ElectroIoT/DotGlow-ESP32/docs/README.md

# Docs

| Read this | If you want to |
|---|---|
| [ARCHITECTURE.md](ARCHITECTURE.md) | understand how the firmware is organised (modules, main loop, settings, safe mode, OTA) |
| [PROTOCOL.md](PROTOCOL.md) | talk to the clock over Bluetooth (every command and reply) |
| [DEVELOPMENT.md](DEVELOPMENT.md) | build, flash and test the firmware yourself |
| [RELEASE.md](RELEASE.md) | publish a new firmware version |
| [`pcb/`](pcb) | pictures of the DotGlow V1 board (2D layout, 3D renders, banner, logos) |

The `*.svg` files in this folder are the animated pictures used in the main README (digit animations, effects, wiring).
They are generated by `tools/make_images.py`, so do not edit them by hand.
