ElectroIoT/DotGlow-ESP32/hardware/pcb/video/index.html

OPEN HARDWARE

DotGlow
V1 Board

From schematic to PCB to 3D

1 SCHEMATIC

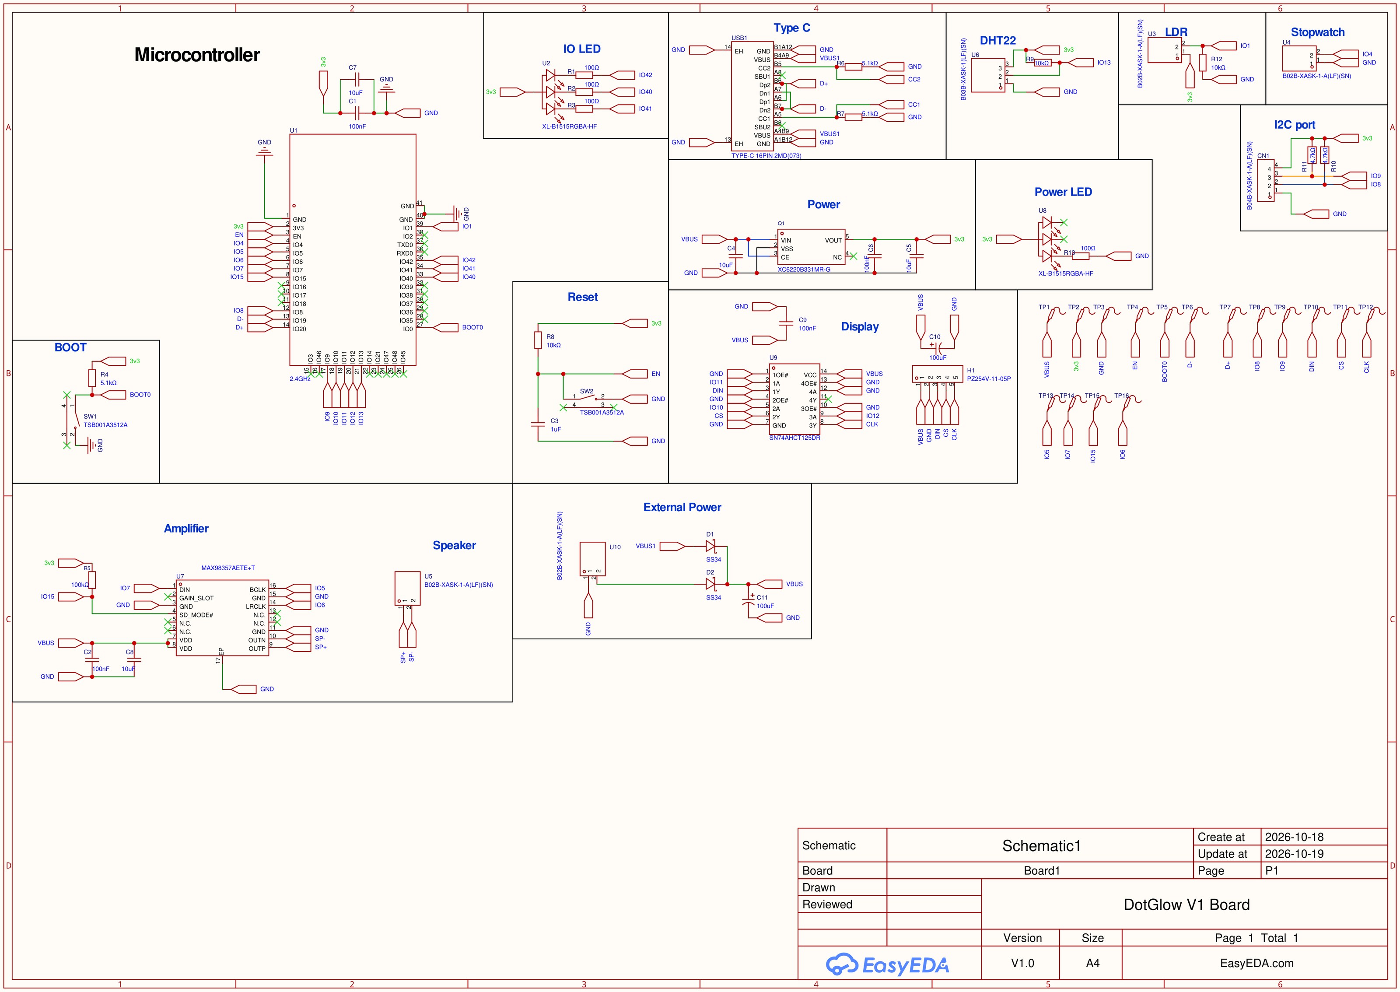
[picture p17: hardware/pcb/video/assets/img/schematic.jpg]
DotGlow V1 schematic


ESP32-S3, USB-C, amplifier, level shifter

0 ERC errors22 BOM lines16 test points

2 PCB LAYOUT

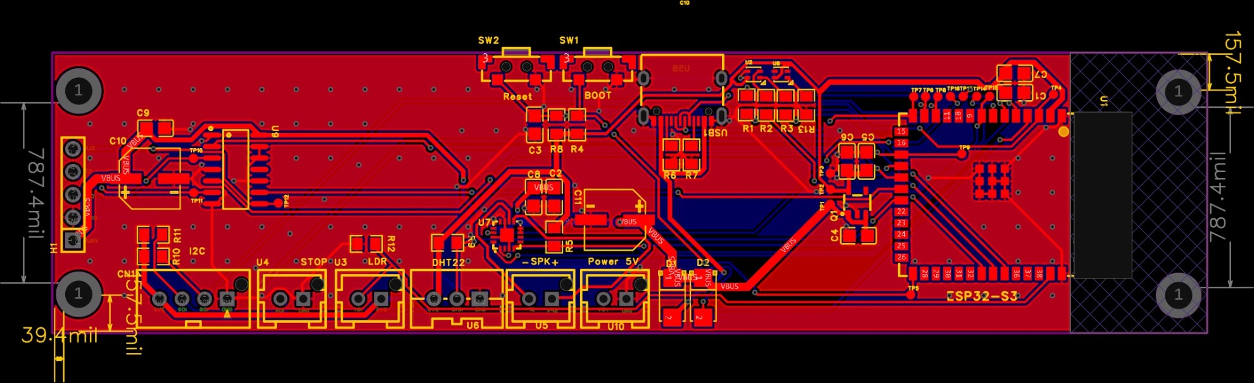
[picture p18: hardware/pcb/video/assets/img/layout2d.jpg]
PCB layout


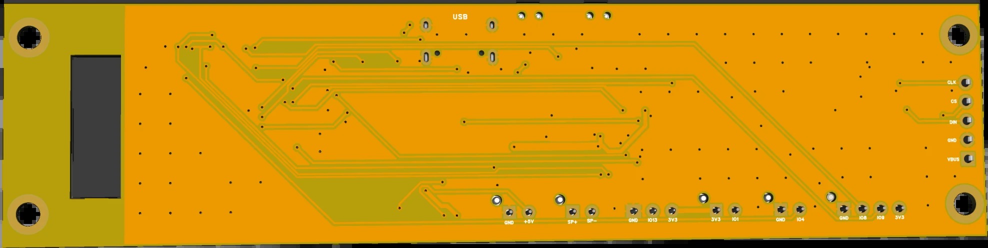
[picture p19: hardware/pcb/video/assets/img/bottom-orange.jpg]
PCB bottom


128 x 31.1 mm, 2 layers

GND pourAntenna keep-outDRC: 0 errorsGerbers ready

3 3D MODEL

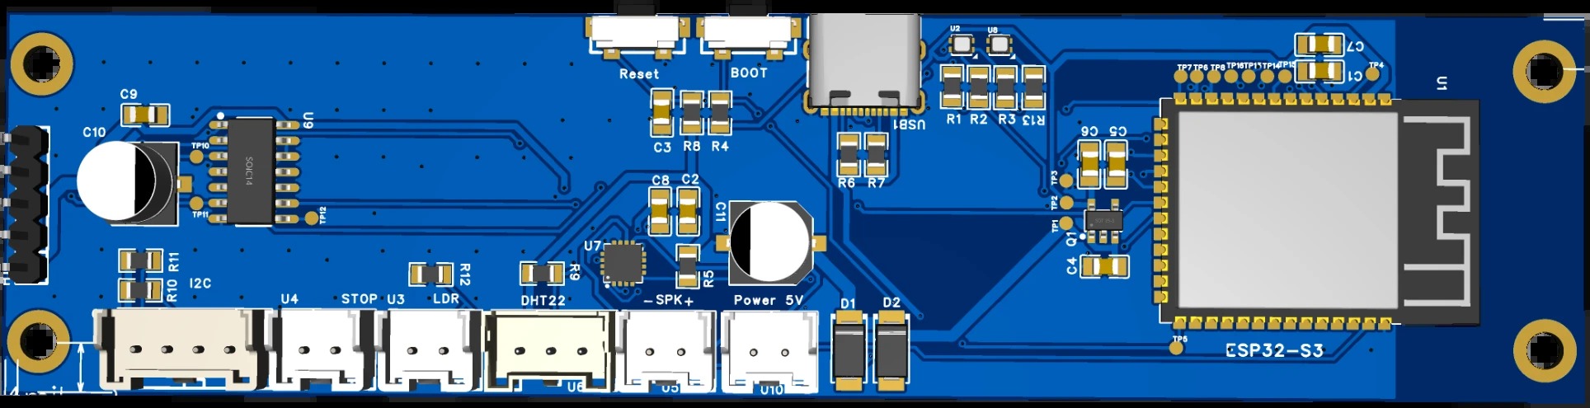
[picture p20: hardware/pcb/video/assets/img/top-blue.jpg]
top


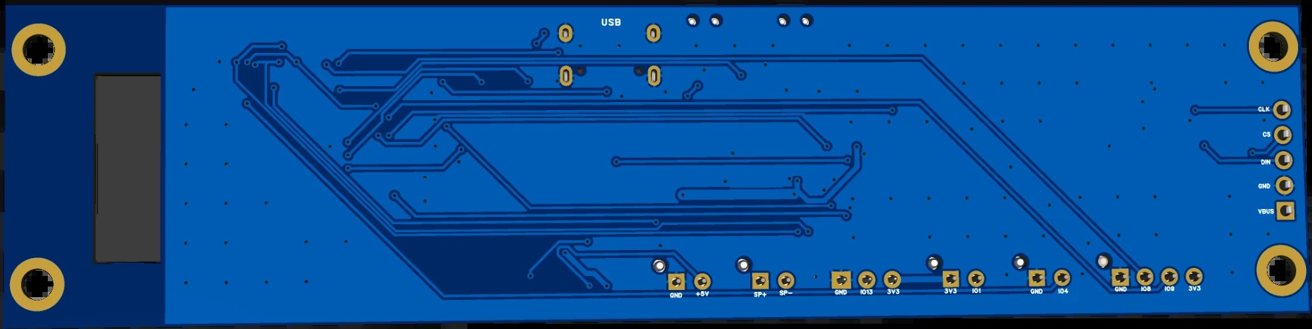
[picture p21: hardware/pcb/video/assets/img/bottom-blue.jpg]
bottom


Top and bottom, every side

3D VIEWER

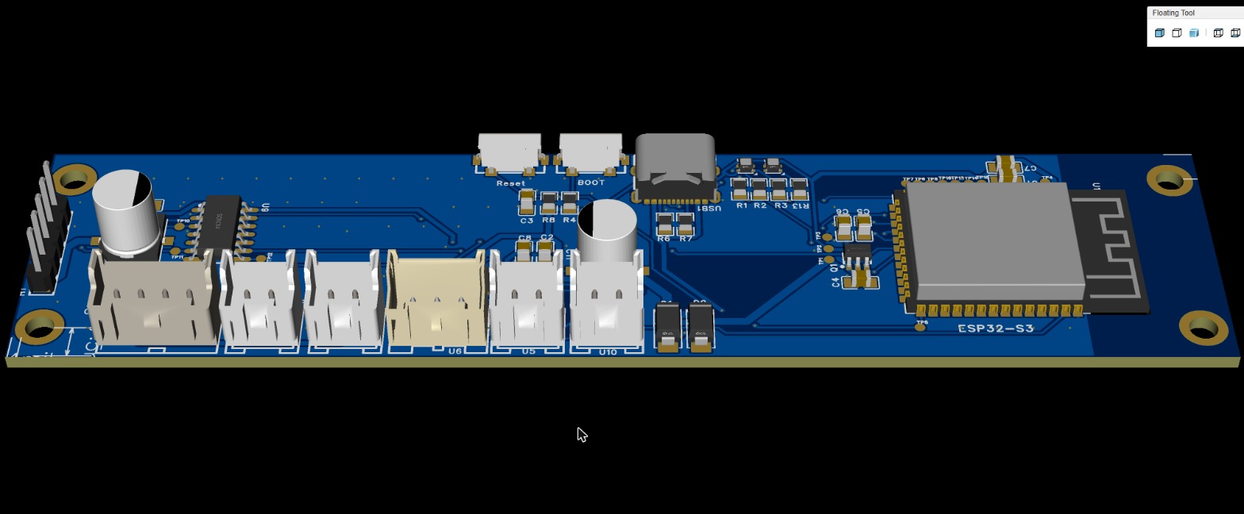
[picture p22: hardware/pcb/video/assets/img/view-front.jpg]
front
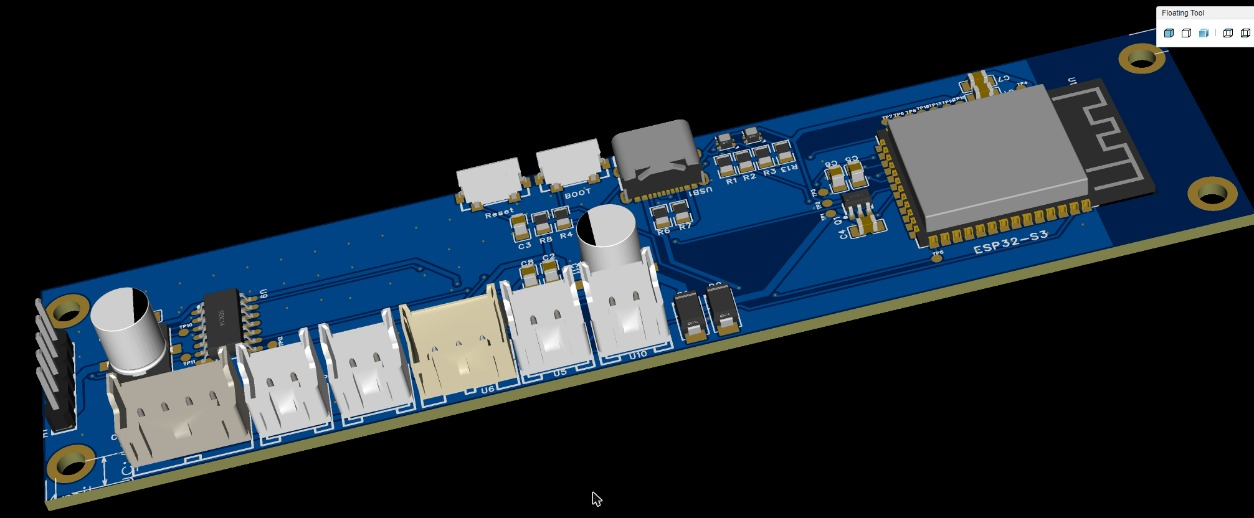
[picture p23: hardware/pcb/video/assets/img/view-angle-1.jpg]
angle 1
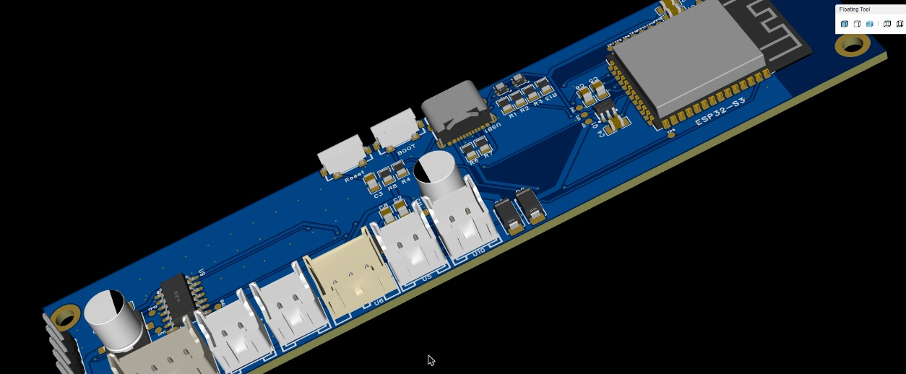
[picture p24: hardware/pcb/video/assets/img/view-angle-2.jpg]
angle 2
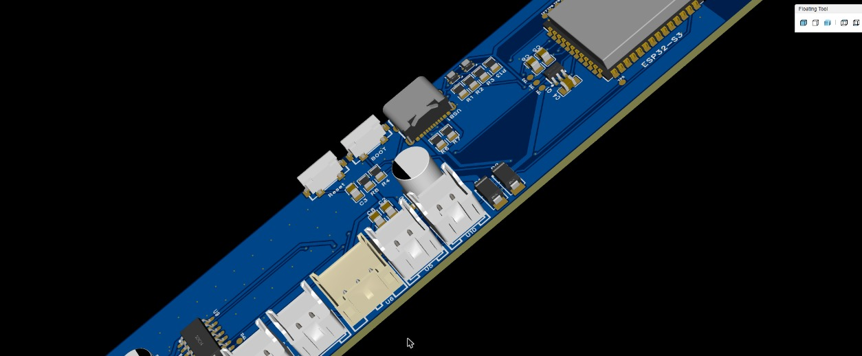
[picture p25: hardware/pcb/video/assets/img/view-angle-3.jpg]
angle 3
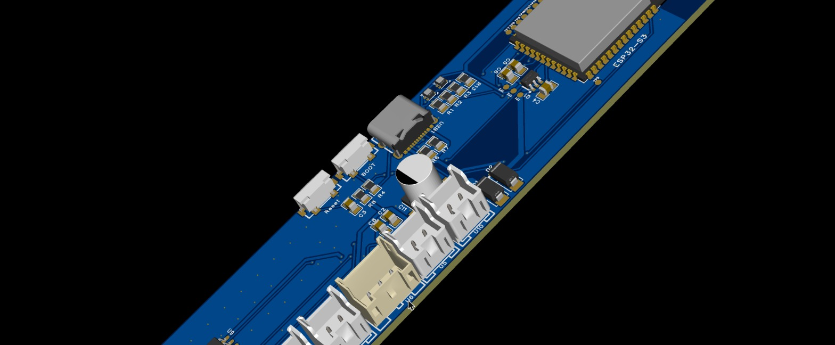
[picture p26: hardware/pcb/video/assets/img/view-closeup.jpg]
closeup
    

Every angle, real parts

USB-C, JST XA connectors, ESP32-S3 module

YOUR COLOUR

blue

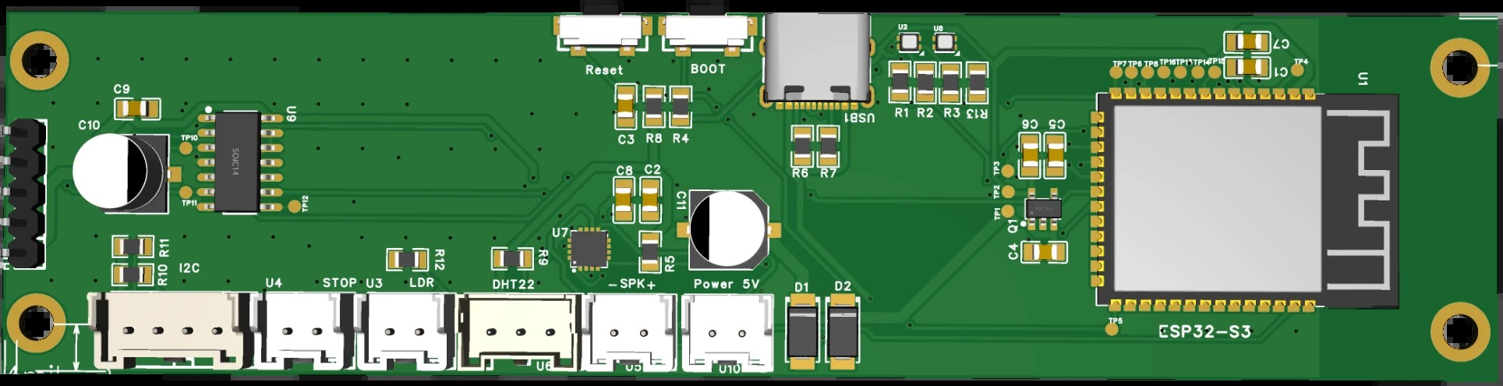
[picture p27: hardware/pcb/video/assets/img/top-green.jpg]
green


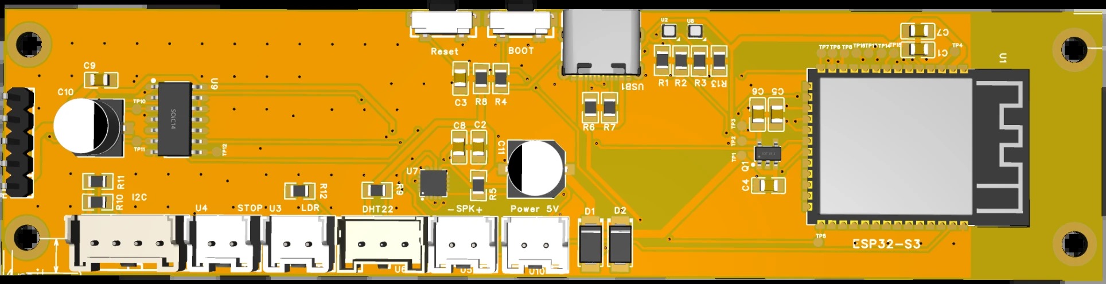
[picture p28: hardware/pcb/video/assets/img/top-orange.jpg]
orange


Blue, green or orange mask

OPEN SOURCE

DotGlow
V1 Board

KiCadEasyEDAGerber + BOM

github.com/ElectroIoT/DotGlow-ESP32

ELECTROIOT.IN
