ElectroIoT/DotGlow-ESP32/docs/pcb/final/pcb-2d-layout.png

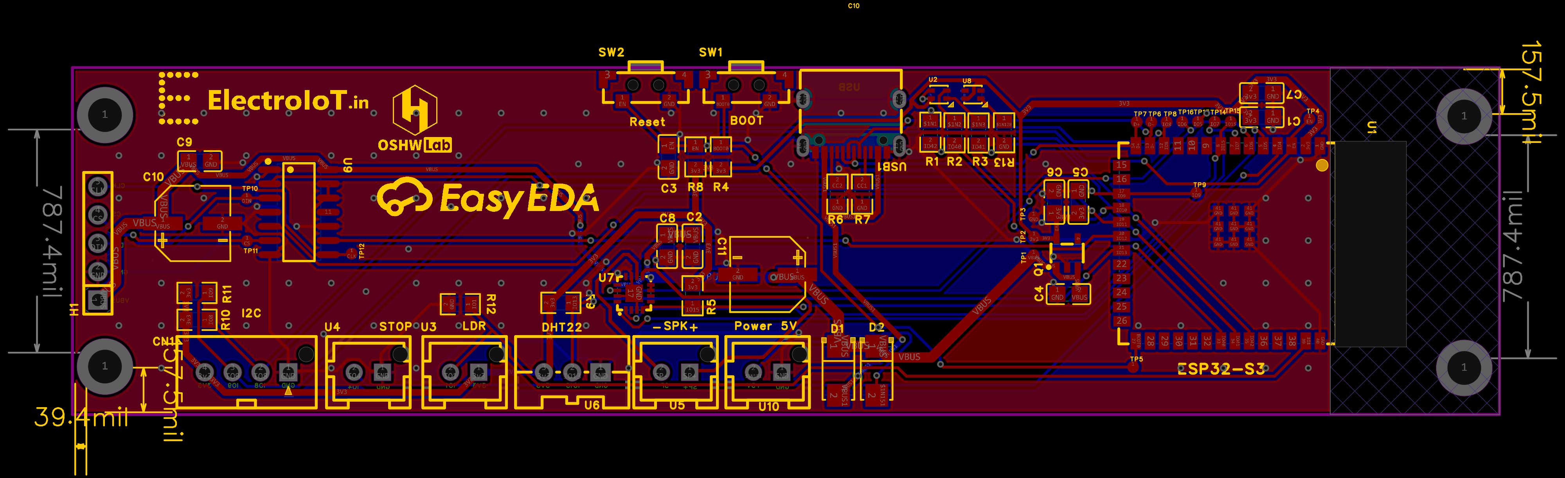
docs/pcb/final/pcb-2d-layout.png
