ElectroIoT/DotGlow-ESP32/docs/pcb/final/pcb-3d-angle-blue.png

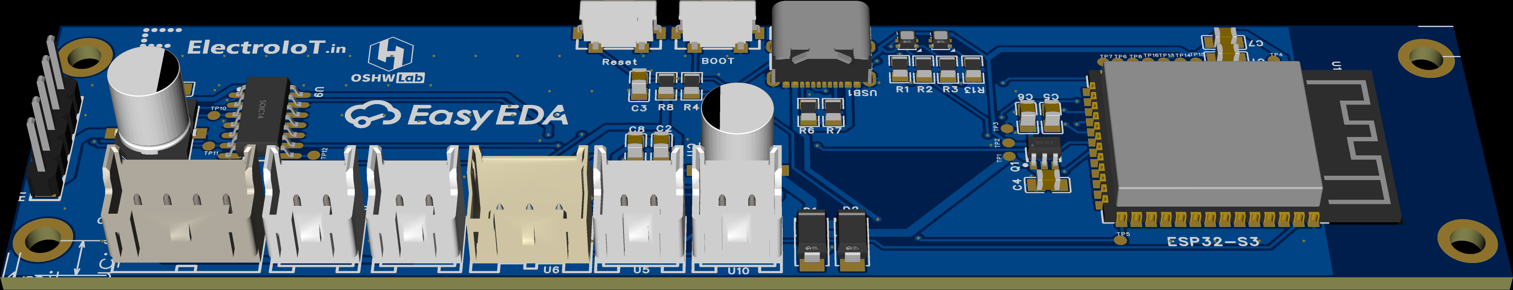
docs/pcb/final/pcb-3d-angle-blue.png
