ElectroIoT/DotGlow-ESP32/docs/pcb/final/pcb-3d-bottom-blue.png

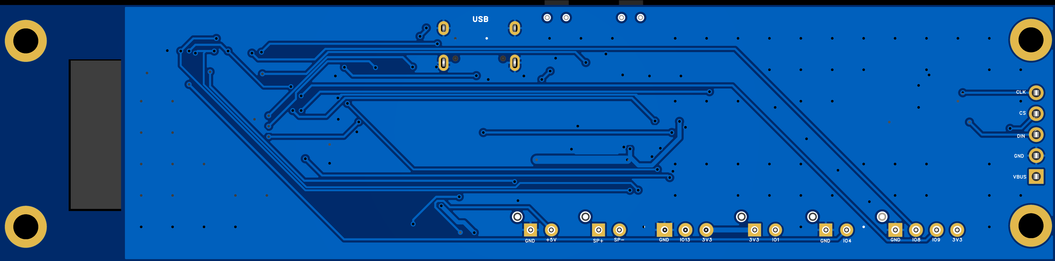
docs/pcb/final/pcb-3d-bottom-blue.png
