ElectroIoT/DotGlow-ESP32/docs/pcb/final/pcb-3d-top-blue.png

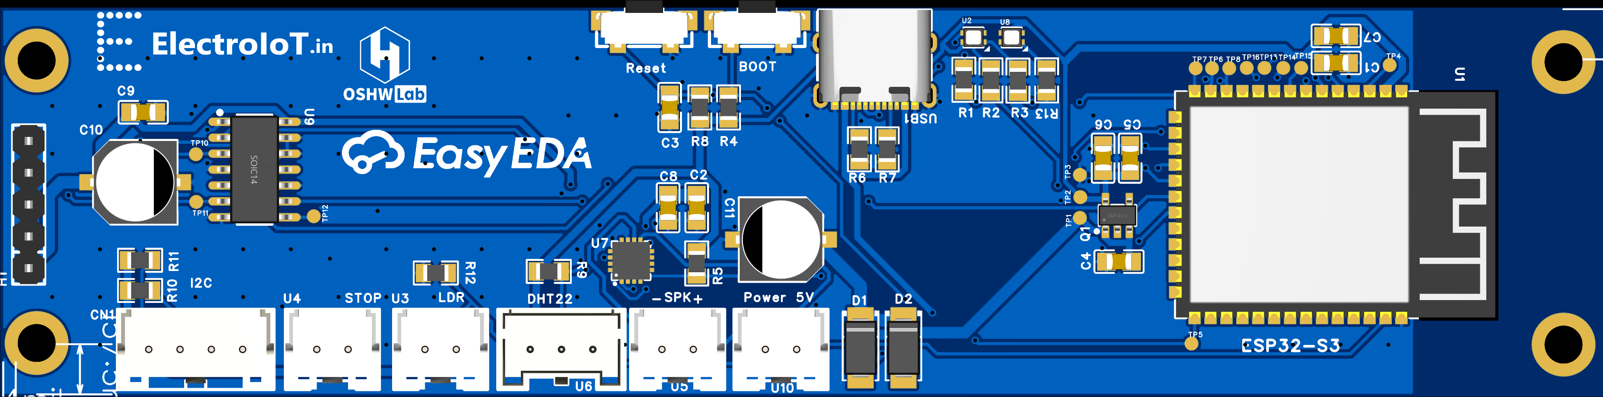
docs/pcb/final/pcb-3d-top-blue.png
