ElectroIoT/DotGlow-ESP32/docs/pcb/oshwlab/clock-animation.gif

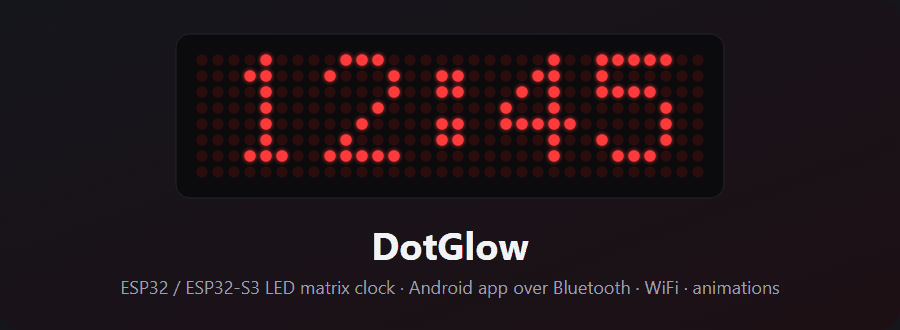
docs/pcb/oshwlab/clock-animation.gif
