ElectroIoT/DotGlow-ESP32/docs/pcb/oshwlab/cover-3d-transparent.png

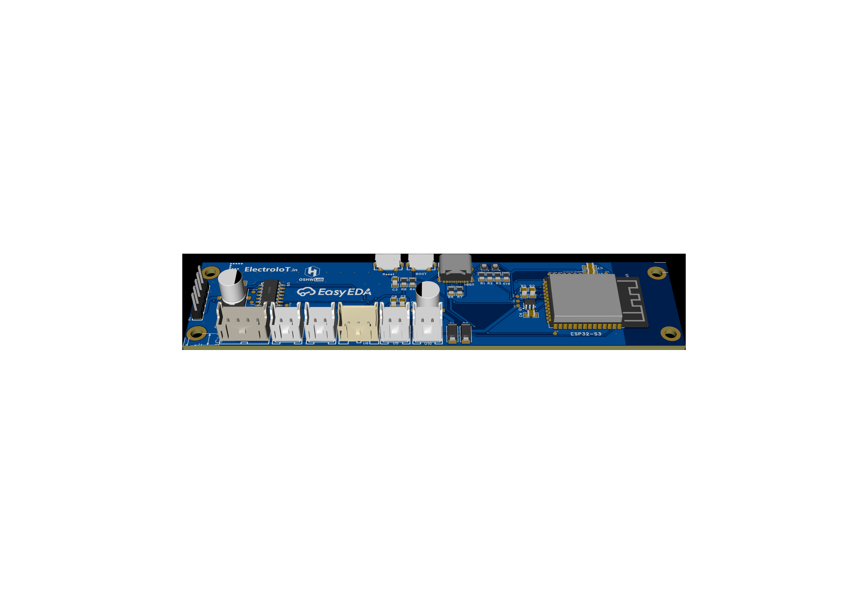
docs/pcb/oshwlab/cover-3d-transparent.png
