ElectroIoT/DotGlow-ESP32/docs/pcb/oshwlab/cover-pcb-3d-padded.jpg

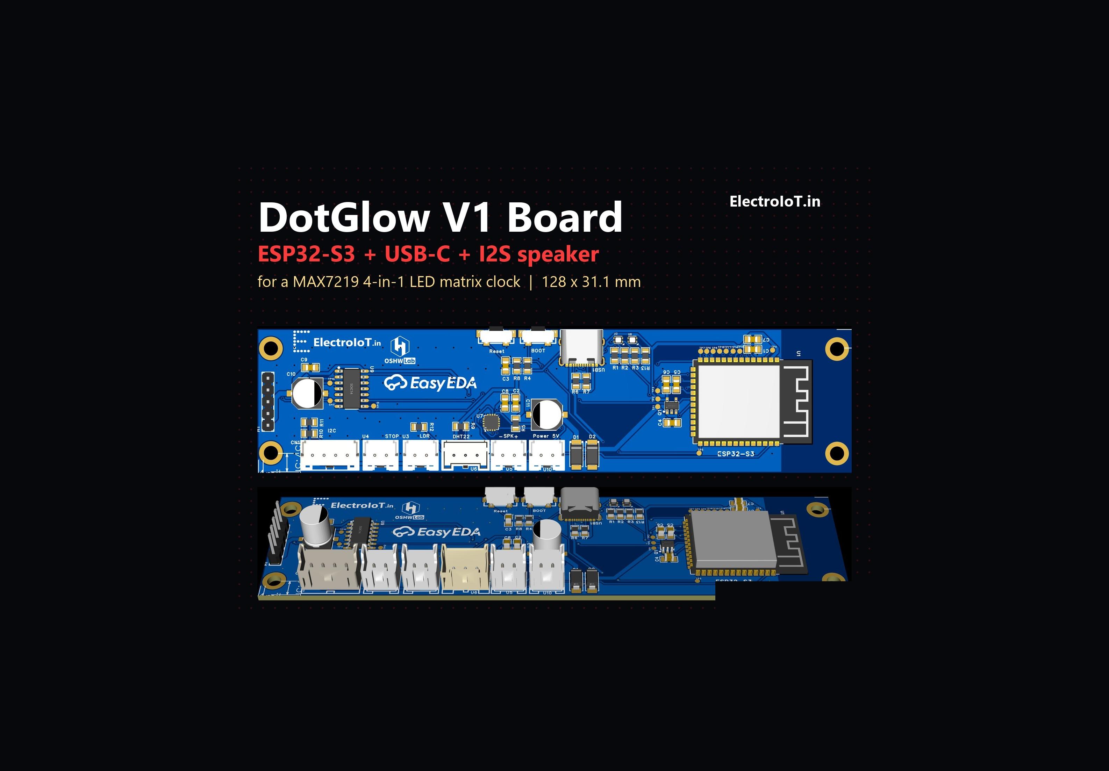
docs/pcb/oshwlab/cover-pcb-3d-padded.jpg
