ElectroIoT/DotGlow-ESP32/docs/pcb/oshwlab/cover-product-padded.jpg

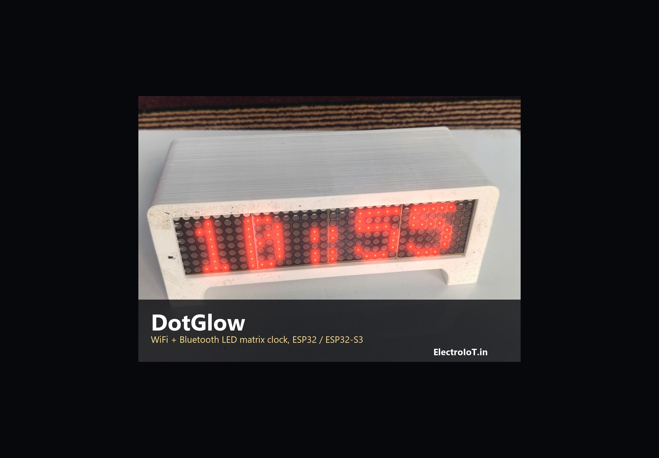
docs/pcb/oshwlab/cover-product-padded.jpg
