ElectroIoT/DotGlow-ESP32/docs/pcb/oshwlab/cover-product.jpg

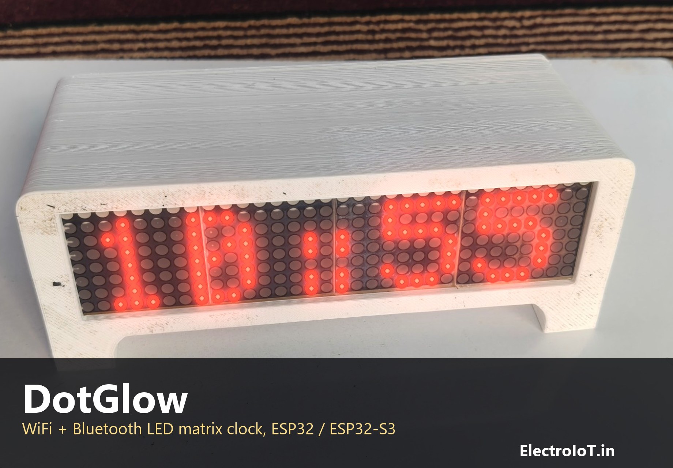
docs/pcb/oshwlab/cover-product.jpg
