ElectroIoT/DotGlow-ESP32/docs/pcb/pcb-3d-bottom-green.png

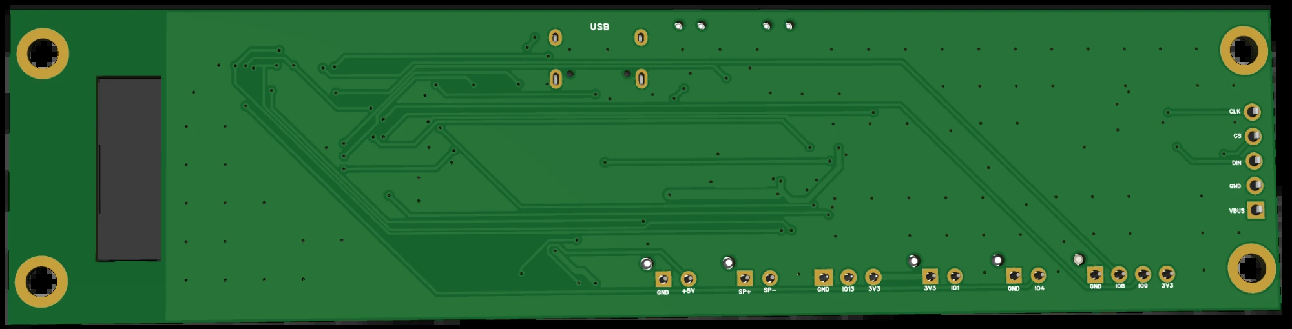
docs/pcb/pcb-3d-bottom-green.png
