ElectroIoT/DotGlow-ESP32/docs/pcb/pcb-3d-side-left.png

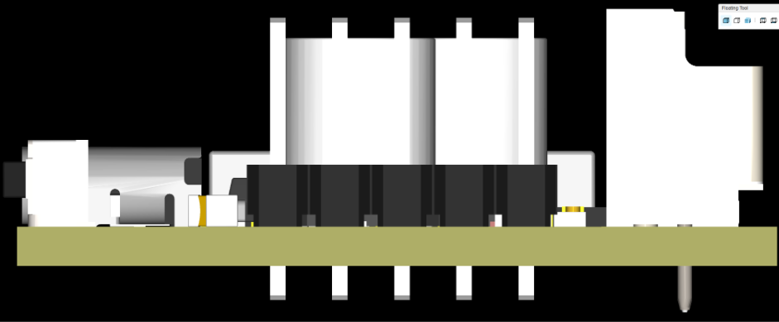
docs/pcb/pcb-3d-side-left.png
