ElectroIoT/DotGlow-ESP32/docs/pcb/pcb-3d-side-right.png

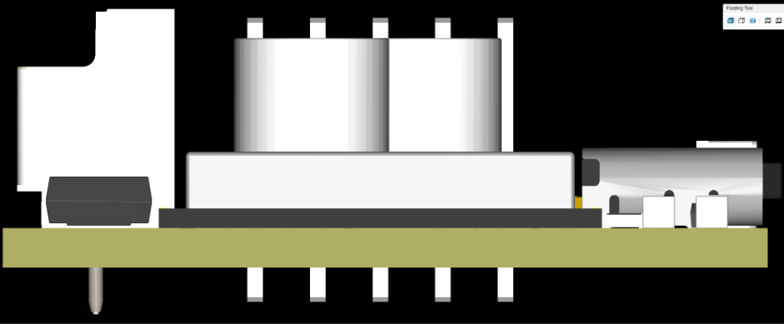
docs/pcb/pcb-3d-side-right.png
