ElectroIoT/DotGlow-ESP32/docs/pcb/pcb-3d-top-orange.png

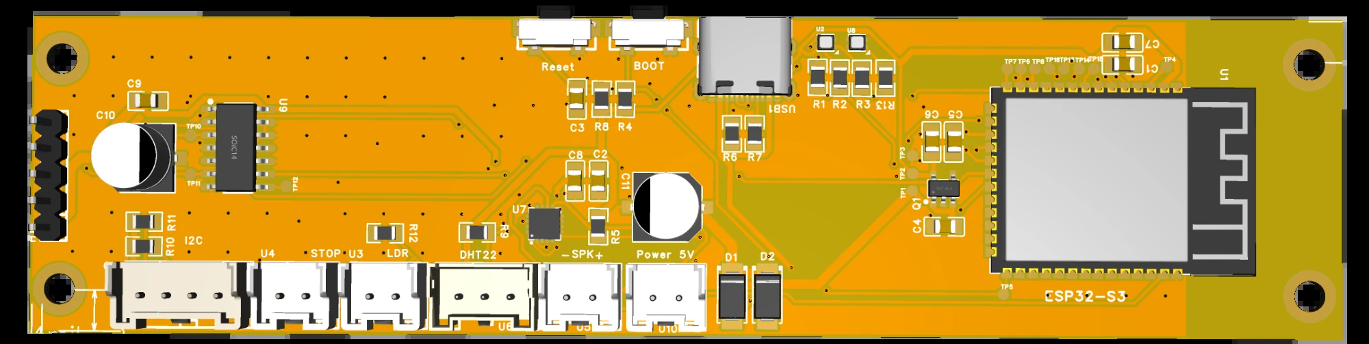
docs/pcb/pcb-3d-top-orange.png
