ElectroIoT/DotGlow-ESP32/docs/pcb/pcbway-cover-7x5.jpg

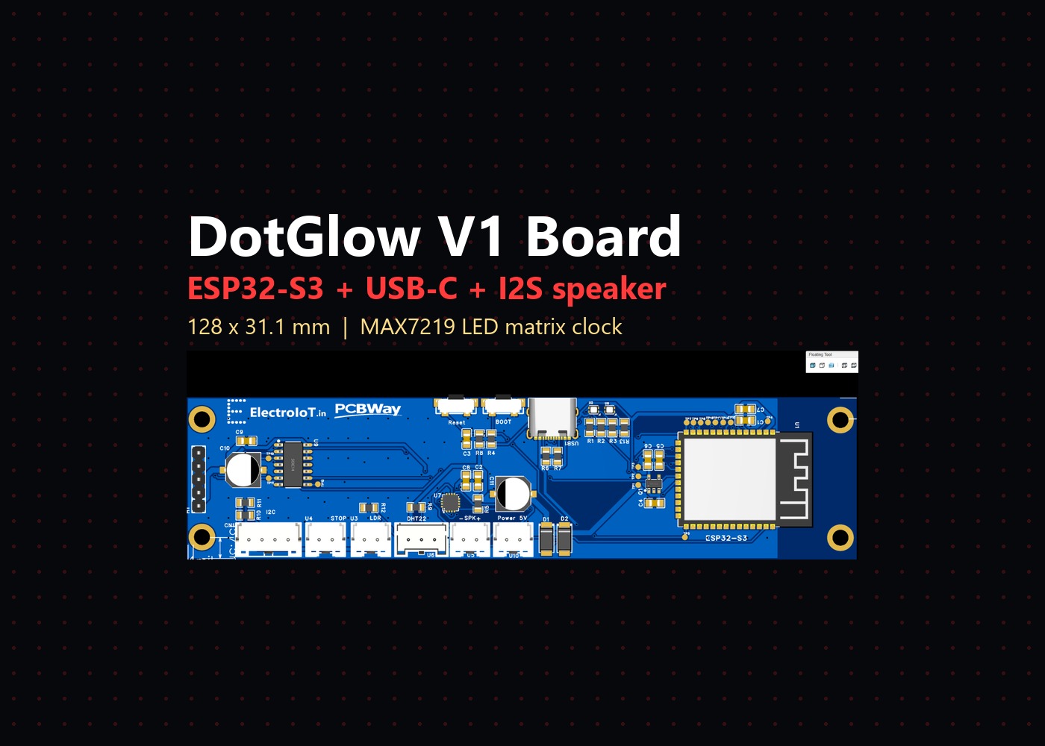
docs/pcb/pcbway-cover-7x5.jpg
