ElectroIoT/DotGlow-ESP32/docs/pcb/pcbway-project-cover.jpg

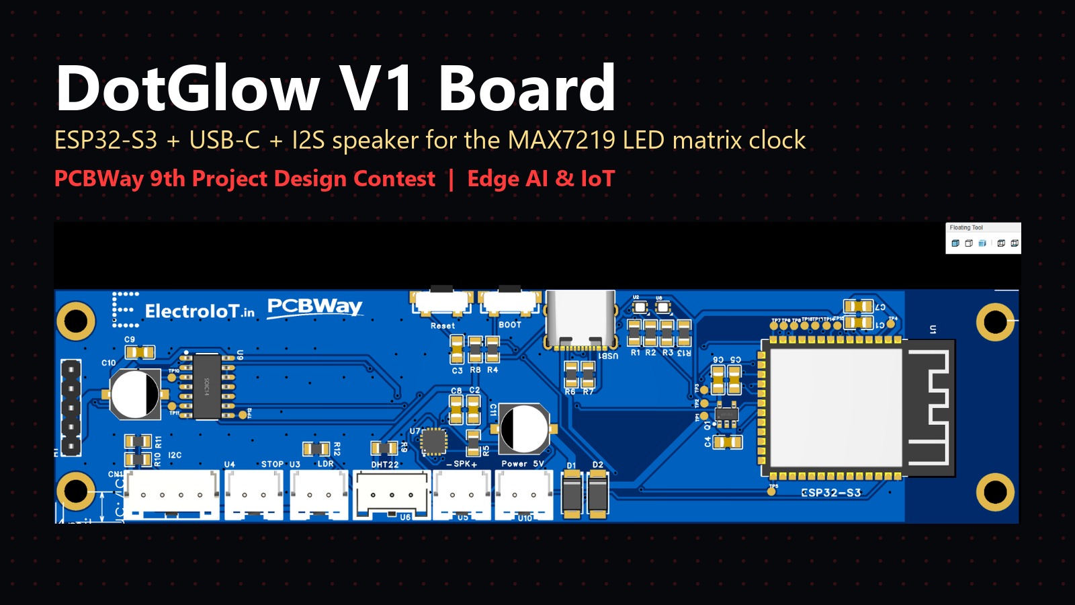
docs/pcb/pcbway-project-cover.jpg
