ElectroIoT/DotGlow-ESP32/docs/pcb/thumb-pcb-short.jpg

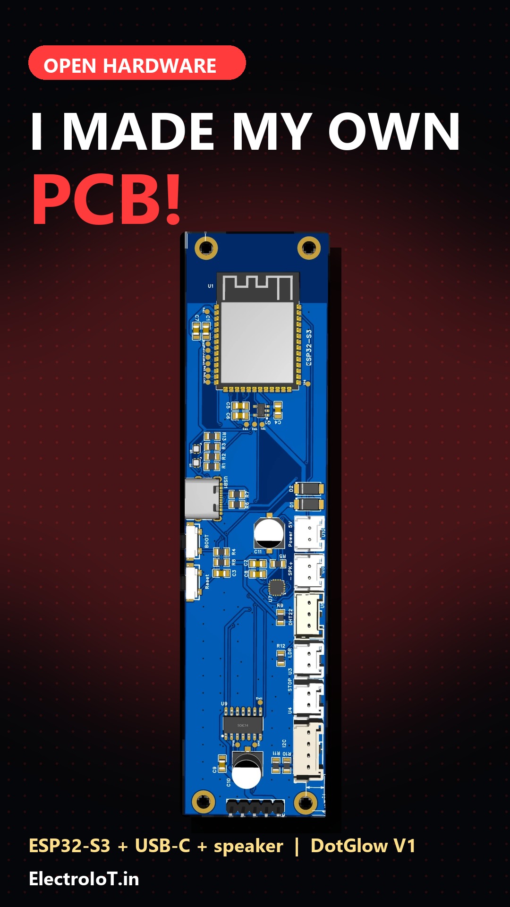
docs/pcb/thumb-pcb-short.jpg
