ElectroIoT/DotGlow-ESP32/docs/pcb/thumb-pcb-wide.jpg

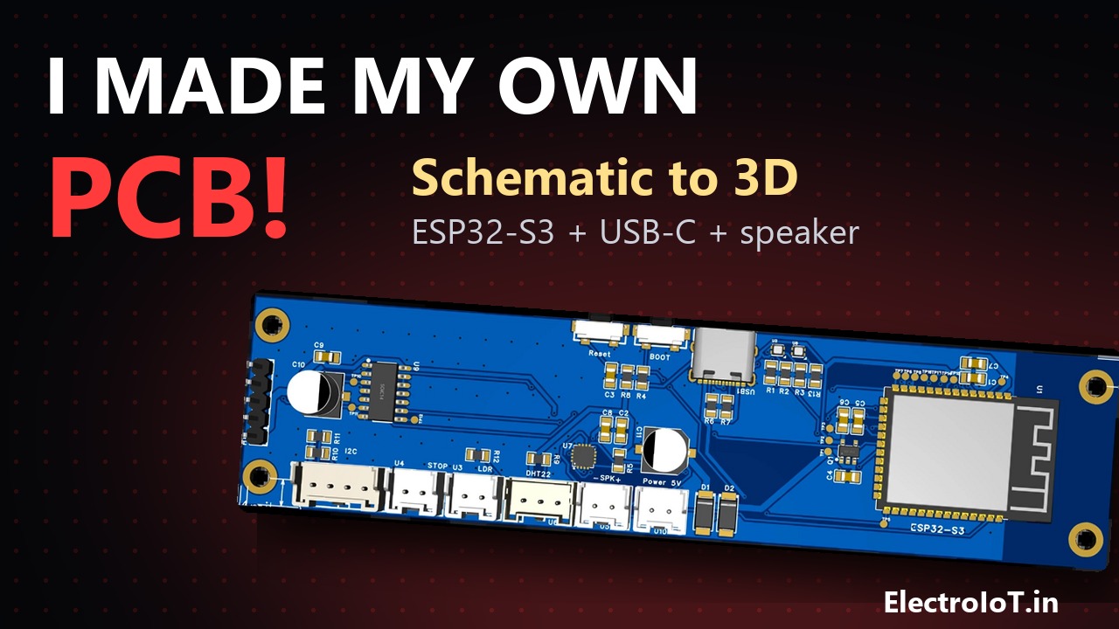
docs/pcb/thumb-pcb-wide.jpg
