ElectroIoT/DotGlow-ESP32/hardware/enclosure/images/case-front-straight.png

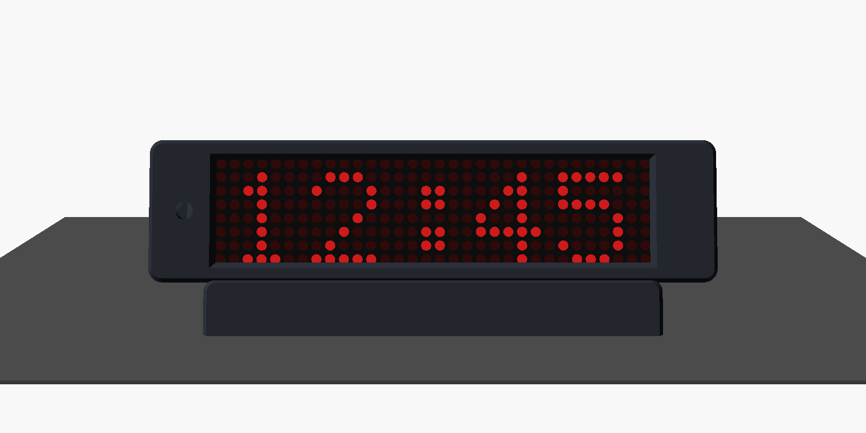
hardware/enclosure/images/case-front-straight.png
