ElectroIoT/DotGlow-ESP32/hardware/pcb/layout/dotglow-v1-layout.png

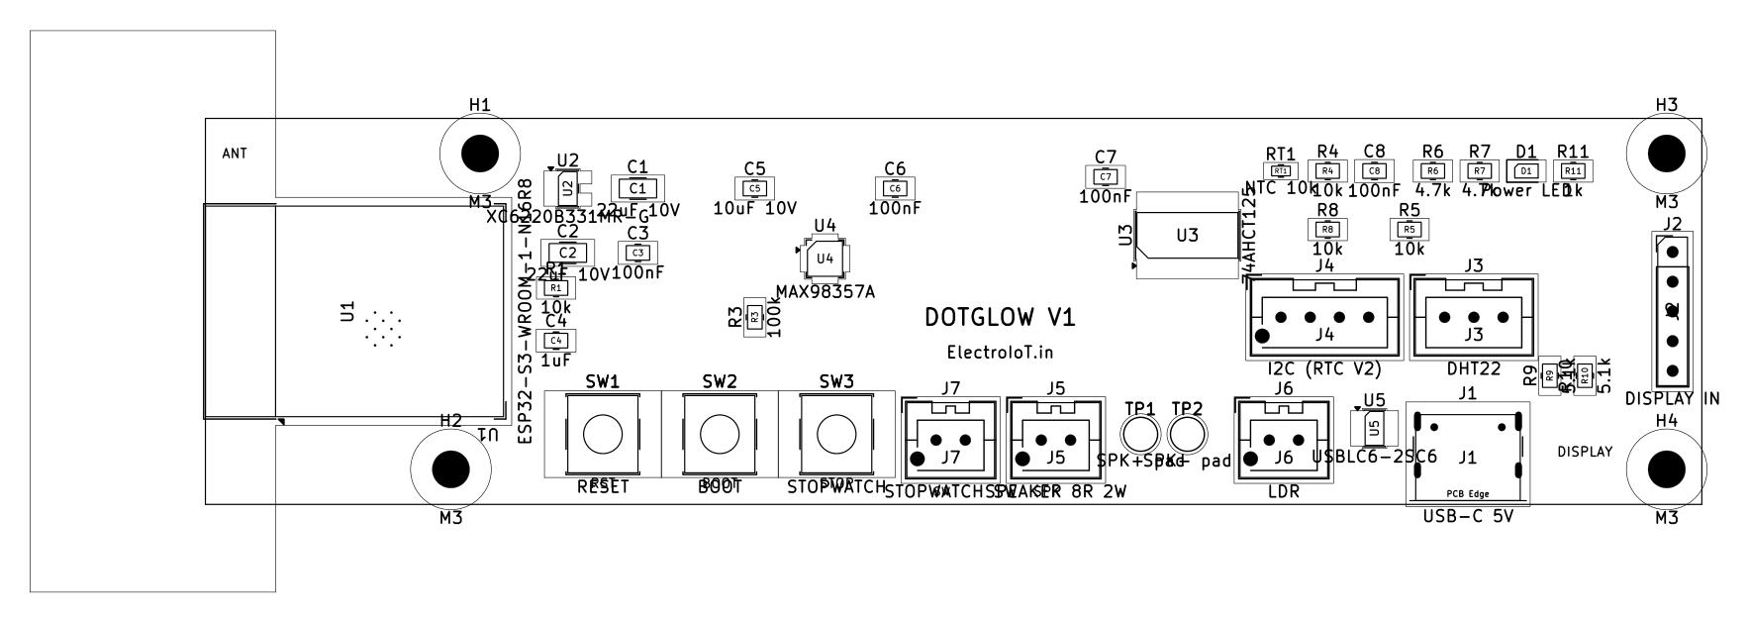
hardware/pcb/layout/dotglow-v1-layout.png
