ElectroIoT/DotGlow-ESP32/hardware/pcb/renders/pcb_bottom.png

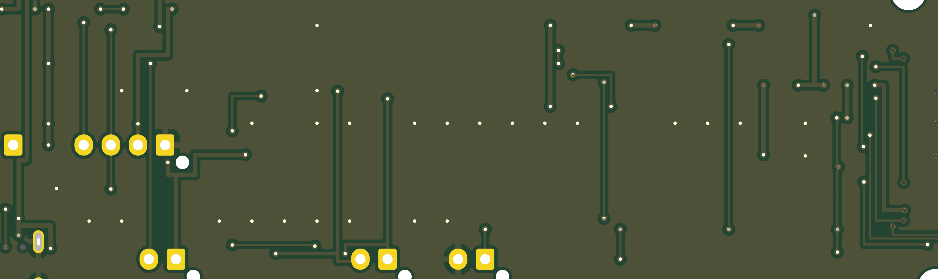
hardware/pcb/renders/pcb_bottom.png
