ElectroIoT/DotGlow-ESP32/hardware/pcb/renders/pcb_top.png

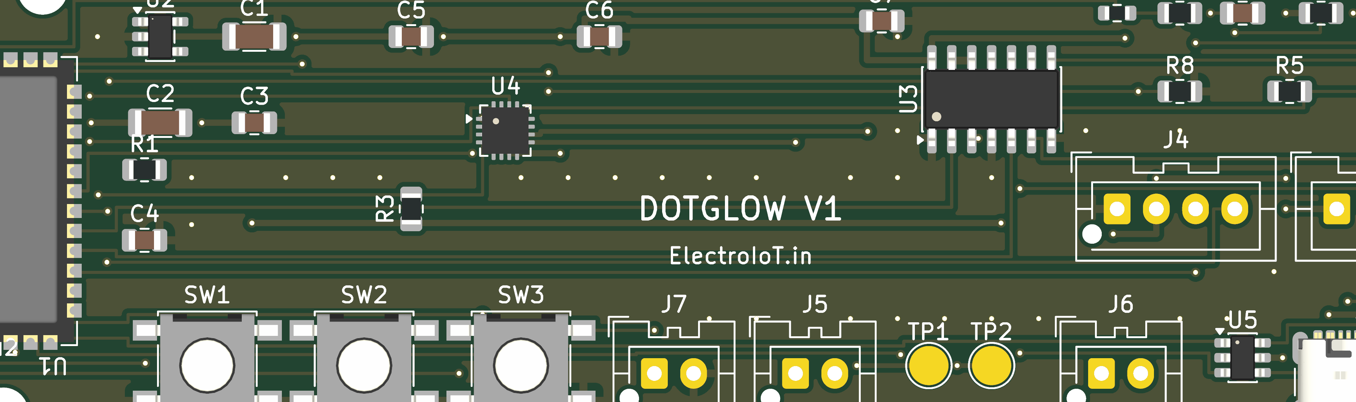
hardware/pcb/renders/pcb_top.png
