ElectroIoT/DotGlow-ESP32/hardware/pcb/bom/dotglow-v1-bom.csv

No. | Quantity | Comment | Designator | Footprint | Value | Manufacturer Part | Manufacturer | Supplier Part | Supplier
1 | 4 | 100nF | C1,C2,C6,C9 | C0805 | 100nF | CC0805KRX7R9BB104 | YAGEO(国巨) | C49678 | LCSC
2 | 1 | 1uF | C3 | C0805 | 1uF | TCC0805X7R105K500DTS | CCTC(三环) | C344178 | LCSC
3 | 4 | 10uF | C4,C5,C7,C8 | C0805 | 10uF | GRM21BR61H106KE43L | muRata(村田) | C440198 | LCSC
4 | 2 | 100uF | C10,C11 | CAP-SMD_BD6.3-L6.6-W6.6-LS7.2-FD | 100uF | RVT1V101M0607 100UF 35V | DMBJ(振宝佳) | C970686 | LCSC
5 | 1 | B04B-XASK-1-A(LF)(SN) | CN1 | CONN-TH_B04B-XASK-1-A-LF-SN |  | B04B-XASK-1-A(LF)(SN) | JST | C491709 | LCSC
6 | 2 | SS34 | D1,D2 | SMA_L4.3-W2.6-LS5.2-RD |  | SS34 | MDD(辰达半导体) | C8678 | LCSC
7 | 1 | PZ254V-11-05P | H1 | HDR-TH_5P-P2.54-V-M |  | PZ254V-11-05P | XFCN(兴飞) | C492404 | LCSC
8 | 1 | XC6220B331MR-G | Q1 | SOT-25_L3.0-W1.6-P0.95-LS2.8-TL |  | XC6220B331MR-G | TOREX(特瑞仕) | C86534 | LCSC
9 | 4 | 100Ω | R1,R2,R3,R13 | R0805 | 100Ω | RC0805FR-07100RL | YAGEO(国巨) | C105577 | LCSC
10 | 3 | 5.1kΩ | R4,R6,R7 | R0805 | 5.1kΩ | 0805W8F5101T5E | UNI-ROYAL(厚声) | C27834 | LCSC
11 | 1 | 100kΩ | R5 | R0805 | 100kΩ | 0805W8F1003T5E | UNI-ROYAL(厚声) | C149504 | LCSC
12 | 3 | 10kΩ | R8,R9,R12 | R0805 | 10kΩ | 0805W8F1002T5E | UNI-ROYAL(厚声) | C17414 | LCSC
13 | 2 | 4.7kΩ | R10,R11 | R0805 | 4.7kΩ | FRC0805F4701TS | FOJAN(富捷) | C2907264 | LCSC
14 | 2 | TSB001A3512A | SW1,SW2 | SW-SMD_TSB001XXXX |  | TSB001A3512A | BZCN(博众电气) | C2888948 | LCSC
15 | 16 | Test-Point | TP1,TP2,TP3,TP4,TP5,TP6,TP7,TP8,TP9,TP10,TP11,TP12,TP13,TP14,TP15,TP16 | Test-Point-0.5mm
16 | 1 | 2.4GHz | U1 | WIRELM-SMD_ESP32-S3-WROOM-1 | 2.4GHz | ESP32-S3-WROOM-1-N16R8 | ESPRESSIF(乐鑫) | C2913202 | LCSC
17 | 2 | XL-B1515RGBA-HF | U2,U8 | LED-SMD_4P-L1.6-W1.5_WHITE-LED |  | XL-B1515RGBA-HF | XINGLIGHT(成兴光) | C22461781 | LCSC
18 | 4 | B02B-XASK-1-A(LF)(SN) | U3,U4,U5,U10 | CONN-TH_B02B-XASK-1-A-LF-SN |  | B02B-XASK-1-A(LF)(SN) | JST | C265077 | LCSC
19 | 1 | B03B-XASK-1(LF)(SN) | U6 | CONN-TH_B03B-XASK-1-LF-SN |  | B03B-XASK-1(LF)(SN) | JST | C265055 | LCSC
20 | 1 | MAX98357AETE+T | U7 | TQFN-16_L3.0-W3.0-P0.50-BL-EP1.5 |  | MAX98357AETE+T | ADI(亚德诺)/MAXIM(美信) | C910544 | LCSC
21 | 1 | SN74AHCT125DR | U9 | SOIC-14_L8.7-W3.9-P1.27-LS6.0-BL |  | SN74AHCT125DR | TI(德州仪器) | C155176 | LCSC
22 | 1 | TYPE-C 16PIN 2MD(073) | USB1 | USB-C-SMD_TYPE-C-16PIN-2MD-073 |  | TYPE-C 16PIN 2MD(073) | SHOU HAN(首韩) | C2765186 | LCSC
