ElectroIoT/DotGlow-ESP32/hardware/pcb/fab/dotglow-v1-bom.csv

Comment | Designator | Footprint | Qty | Suggested part / note
22uF 10V | C1,C2 | C_1206_3216Metric | 2
100nF | C3,C6,C7,C8 | C_0805_2012Metric | 4
1uF | C4 | C_0805_2012Metric | 1
10uF 10V | C5 | C_0805_2012Metric | 1
Power LED | D1 | LED_0805_2012Metric | 1
USB-C 5V | J1 | USB_C_Receptacle_GCT_USB4105-xx-A_16P_TopMnt_Horizontal | 1 | GCT USB4105-GF-A
DISPLAY IN | J2 | PinHeader_1x05_P2.54mm_Vertical | 1 | XFCN PZ254V-11-05P 1x5 pin header (LCSC C492404)
DHT22 | J3 | JST_XA_B03B-XASK-1_1x03_P2.50mm_Vertical | 1 | JST B03B-XASK-1 (LCSC C265055)
I2C (RTC V2) | J4 | JST_XA_B04B-XASK-1-A_1x04_P2.50mm_Vertical | 1 | JST B04B-XASK-1-A (LCSC C491709)
SPEAKER 8R 2W | J5 | JST_XA_B02B-XASK-1-A_1x02_P2.50mm_Vertical | 1 | JST B02B-XASK-1-A (LCSC C265077)
LDR | J6 | JST_XA_B02B-XASK-1-A_1x02_P2.50mm_Vertical | 1 | JST B02B-XASK-1-A (LCSC C265077)
STOPWATCH SW | J7 | JST_XA_B02B-XASK-1-A_1x02_P2.50mm_Vertical | 1 | JST B02B-XASK-1-A (LCSC C265077)
10k | R1,R4,R5,R8 | R_0805_2012Metric | 4
1k | R11 | R_0805_2012Metric | 1
100k | R3 | R_0805_2012Metric | 1
4.7k | R6,R7 | R_0805_2012Metric | 2
5.1k | R10,R9 | R_0805_2012Metric | 2
NTC 10k | RT1 | R_0603_1608Metric | 1 | 10k NTC, B=3950, 0603 (e.g. NCP18XH103F03RB)
RESET | SW1 | SW_SPST_B3S-1000 | 1 | 6x6 SMD tact switch
BOOT | SW2 | SW_SPST_B3S-1000 | 1 | 6x6 SMD tact switch
STOPWATCH | SW3 | SW_SPST_B3S-1000 | 1 | 6x6 SMD tact switch
SPK+ pad | TP1 | TestPoint_Pad_D2.5mm | 1
SPK- pad | TP2 | TestPoint_Pad_D2.5mm | 1
ESP32-S3-WROOM-1-N16R8 | U1 | ESP32-S3-WROOM-1 | 1 | ESP32-S3-WROOM-1-N16R8 (LCSC C2913202)
XC6220B331MR-G | U2 | SOT-23-5 | 1 | XC6220B331MR-G (LCSC C86534), 1 A, pin-compatible with AP2112K-3.3 (C51118)
74AHCT125 | U3 | SOIC-14_3.9x8.7mm_P1.27mm | 1 | SN74AHCT125DR (LCSC C155176)
MAX98357A | U4 | TQFN-16-1EP_3x3mm_P0.5mm_EP1.6x1.6mm | 1 | MAX98357AETE+T (LCSC C910544)
USBLC6-2SC6 | U5 | SOT-23-6 | 1 | USBLC6-2SC6
