ElectroIoT/DotGlow-ESP32/hardware/pcb/layout/dotglow-v1-full-layout.dxf

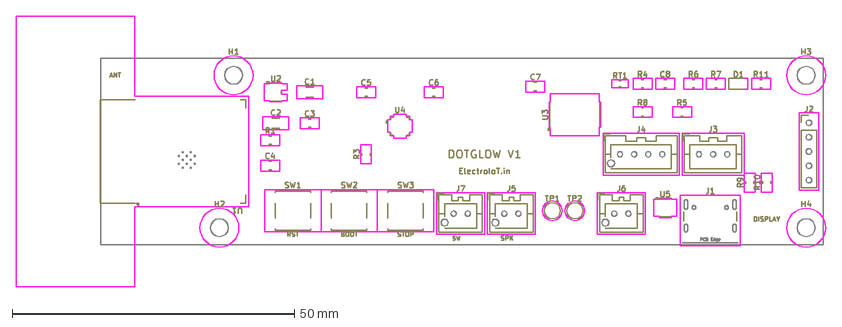
[picture p51: CAD file, 2026-10-20]
hardware/pcb/layout/dotglow-v1-full-layout.dxf
143.4 x 48.0 mm
