ElectroIoT/DotGlow-ESP32/hardware/enclosure/stl/6-modules-plus/dotglow-testfit.stl

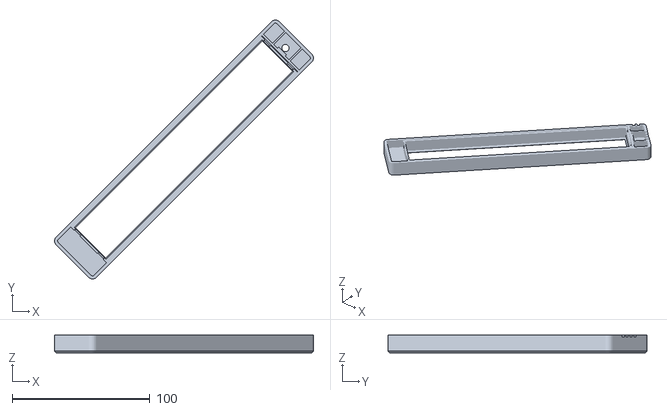
[picture p52: CAD file, 2026-10-05]
hardware/enclosure/stl/6-modules-plus/dotglow-testfit.stl
187.7 x 187.7 x 12.8
