ElectroIoT/DotGlow-ESP32/hardware/enclosure/stl/6-modules-plus/esp32-devkit-30pin/shell-no-button.stl

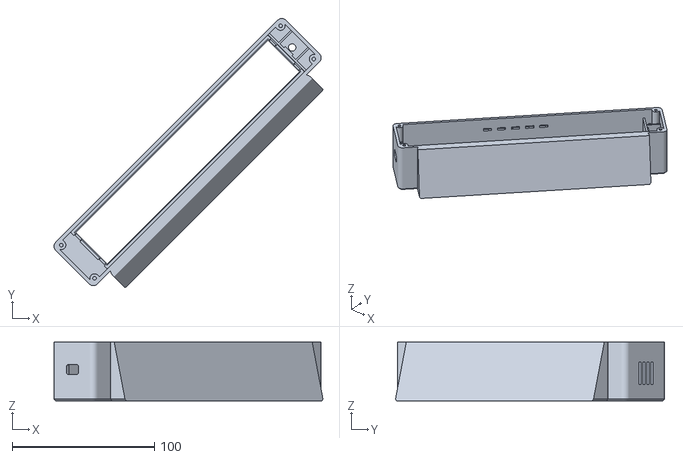
[picture p53: CAD file, 2026-10-05]
hardware/enclosure/stl/6-modules-plus/esp32-devkit-30pin/shell-no-button.stl
189.1 x 189.1 x 41.2
