ElectroIoT/DotGlow-ESP32/hardware/enclosure/stl/6-modules-plus/esp32-devkit-38pin/back.stl

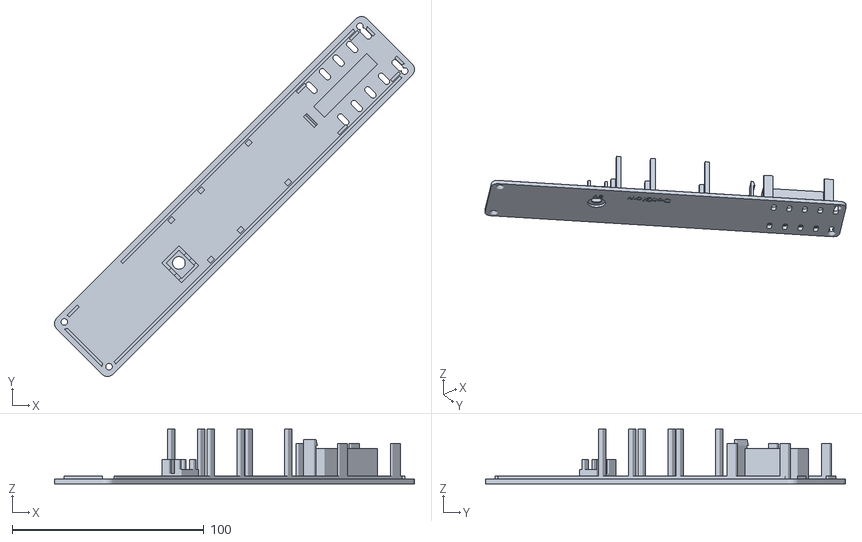
[picture p54: CAD file, 2026-10-05]
hardware/enclosure/stl/6-modules-plus/esp32-devkit-38pin/back.stl
187.7 x 187.7 x 28.5
