ElectroIoT/DotGlow-ESP32/hardware/enclosure/stl/6-modules-plus/esp8266-nodemcu-v3/shell-snap-button.stl

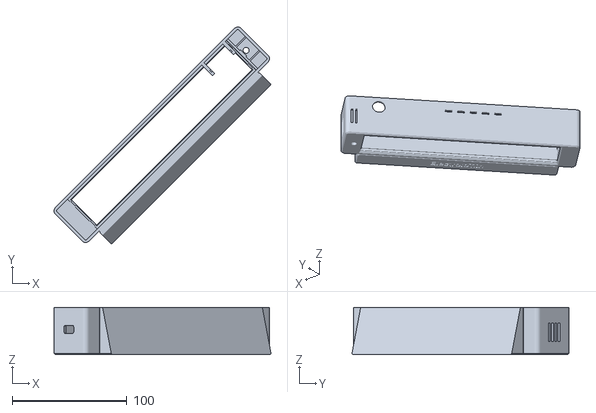
[picture p56: CAD file, 2026-10-05]
hardware/enclosure/stl/6-modules-plus/esp8266-nodemcu-v3/shell-snap-button.stl
189.1 x 189.1 x 41.2
