ElectroIoT/DotGlow-ESP32/hardware/enclosure/stl/6-modules/dotglow-testfit.stl

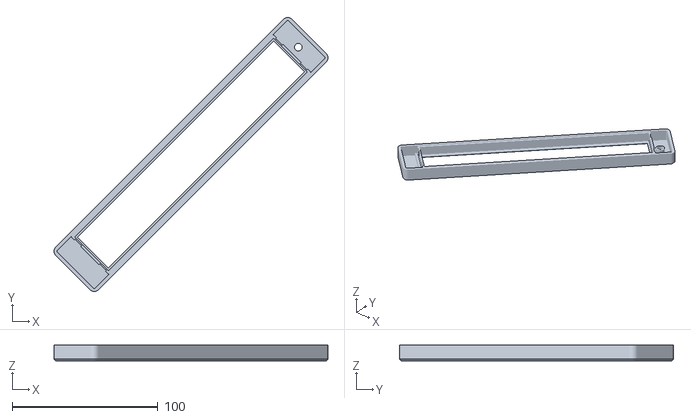
[picture p57: CAD file, 2026-10-05]
hardware/enclosure/stl/6-modules/dotglow-testfit.stl
187.7 x 187.7 x 10.8
