ElectroIoT/DotGlow-ESP32/hardware/enclosure/stl/dotglow-testfit.stl

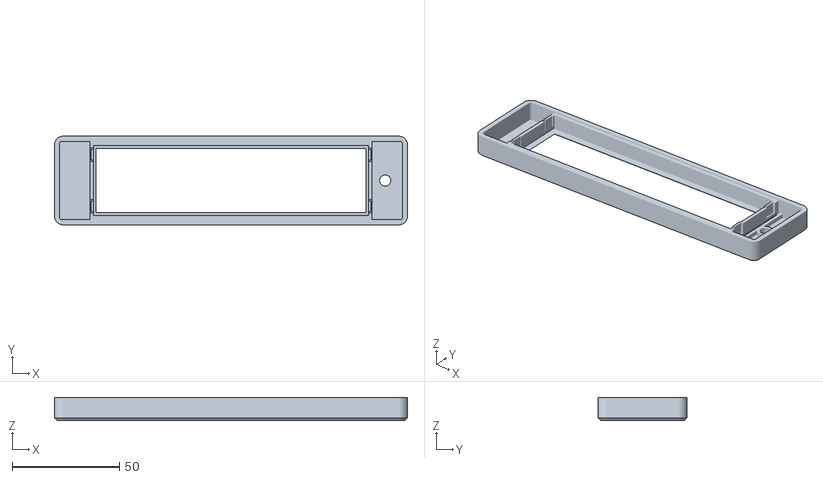
[picture p58: CAD file, 2026-10-05]
hardware/enclosure/stl/dotglow-testfit.stl
164.8 x 41.4 x 10.8
