ElectroIoT/DotGlow-ESP32/hardware/enclosure/stl/extras/esp32-s3-back-panel-jack.stl

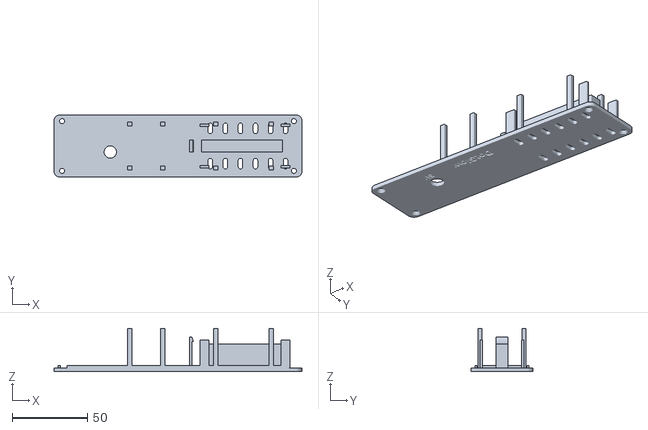
[picture p59: CAD file, 2026-10-05]
hardware/enclosure/stl/extras/esp32-s3-back-panel-jack.stl
164.8 x 41.4 x 28.8
