ElectroIoT/DotGlow-ESP32/hardware/enclosure/stl/variants/dotglow-shell-snap.stl

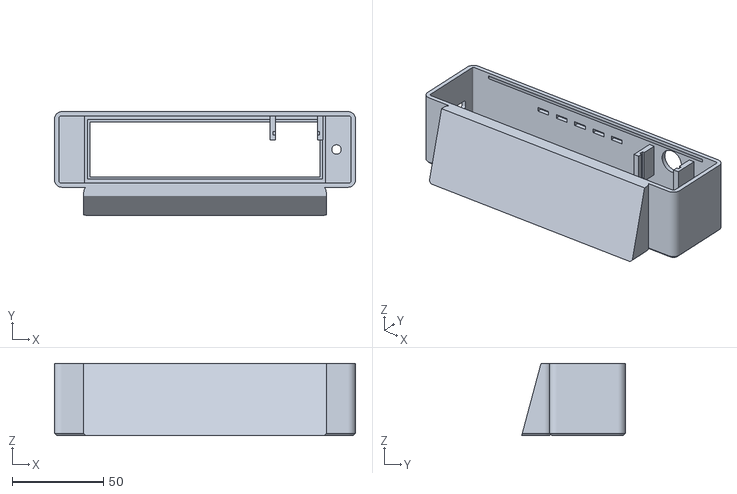
[picture p60: CAD file, 2026-10-05]
hardware/enclosure/stl/variants/dotglow-shell-snap.stl
164.8 x 56.8 x 39.5
