ElectroIoT/DotGlow-ESP32/hardware/enclosure/stl/6-modules-plus/dotglow-nameplate-inlay.stl

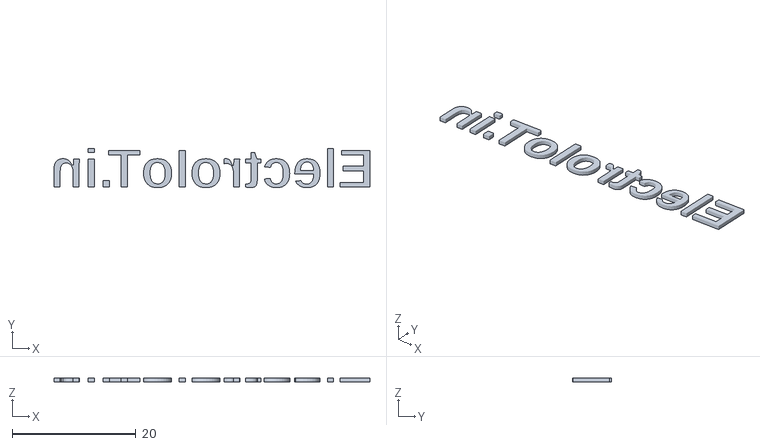
[picture p61: CAD file, 2026-10-05]
hardware/enclosure/stl/6-modules-plus/dotglow-nameplate-inlay.stl
51.1 x 6.39 x 0.6
