ElectroIoT/DotGlow-ESP32/hardware/enclosure/stl/extras/esp32-s3-shell-lean30-button.stl

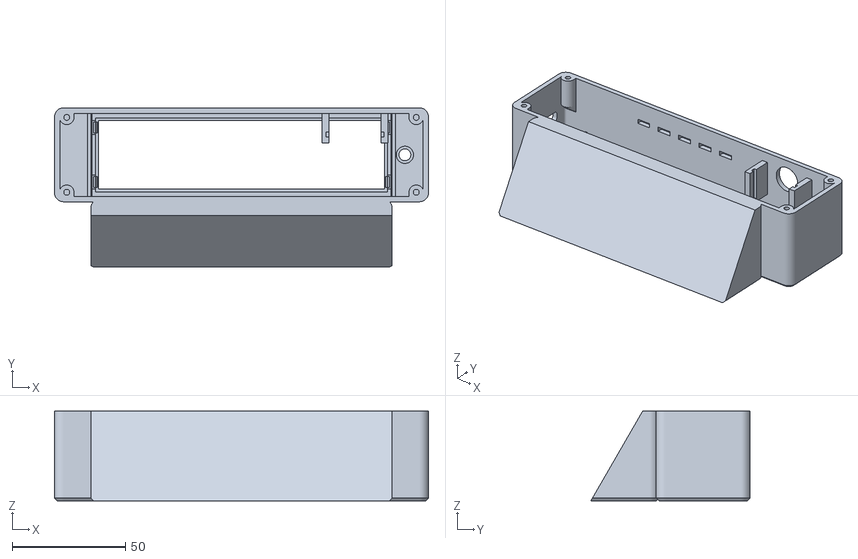
[picture p62: CAD file, 2026-10-05]
hardware/enclosure/stl/extras/esp32-s3-shell-lean30-button.stl
164.8 x 70.2 x 39.5
