ElectroIoT/DotGlow-ESP32/hardware/pcb/layout/dotglow-v1-outline-128x31p1.dxf

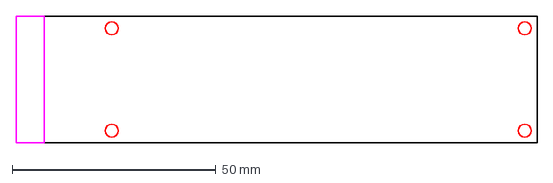
[picture p63: CAD file, 2026-10-20]
hardware/pcb/layout/dotglow-v1-outline-128x31p1.dxf
128.0 x 31.1 mm
