ElectroIoT/DotGlow-ESP32/hardware/enclosure/stl/6-modules-plus/dotglow-light-shield.stl

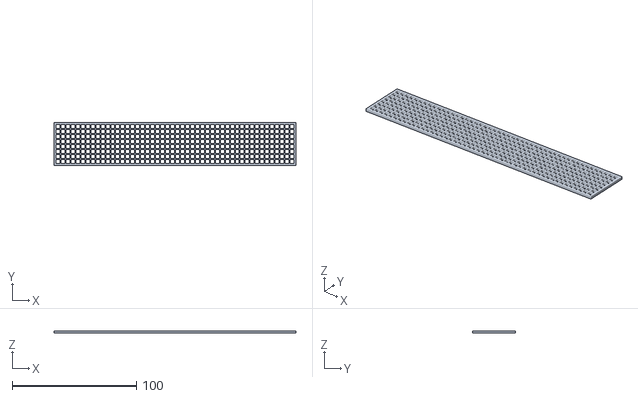
[picture p64: CAD file, 2026-10-05]
hardware/enclosure/stl/6-modules-plus/dotglow-light-shield.stl
194.4 x 34.4 x 2.00
