ElectroIoT/DotGlow-ESP32/hardware/enclosure/stl/6-modules-plus/esp32-s3/back-snap.stl

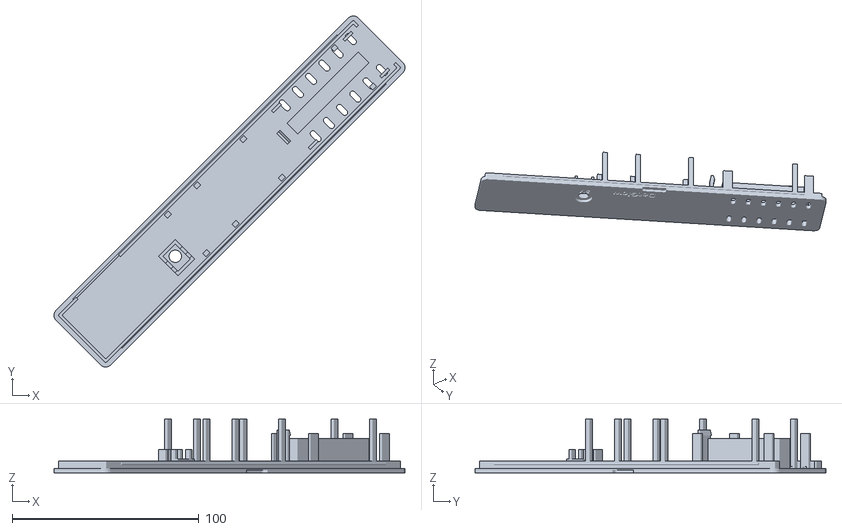
[picture p65: CAD file, 2026-10-05]
hardware/enclosure/stl/6-modules-plus/esp32-s3/back-snap.stl
187.7 x 187.7 x 28.8
