ElectroIoT/DotGlow-ESP32/hardware/pcb/layout/dotglow-v1-outline-holes.dxf

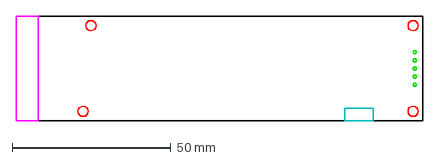
[picture p67: CAD file, 2026-10-20]
hardware/pcb/layout/dotglow-v1-outline-holes.dxf
128.0 x 33.0 mm
