ElectroIoT/DotGlow-ESP32/hardware/enclosure/stl/6-modules-plus/esp32-s3/back.stl

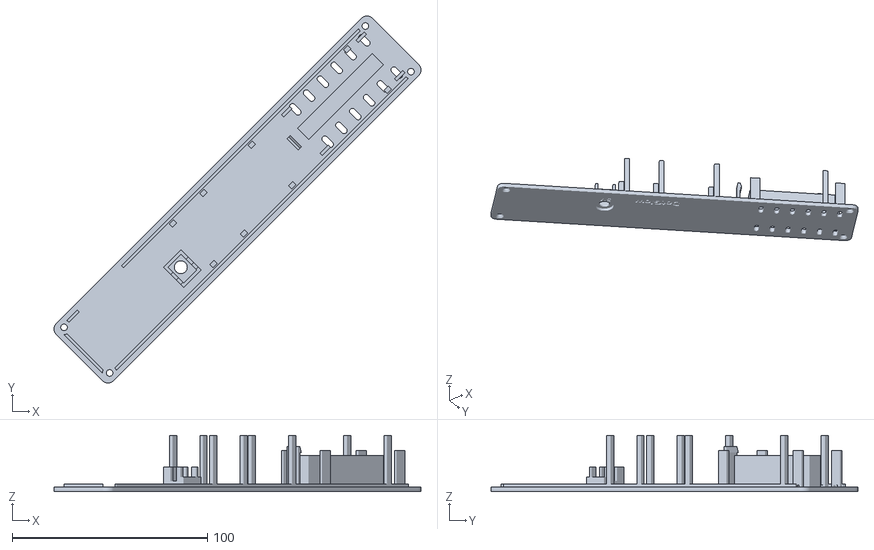
[picture p68: CAD file, 2026-10-05]
hardware/enclosure/stl/6-modules-plus/esp32-s3/back.stl
187.7 x 187.7 x 28.8
