ElectroIoT/DotGlow-ESP32/hardware/enclosure/stl/6-modules-plus/esp32-s3/shell-button.stl

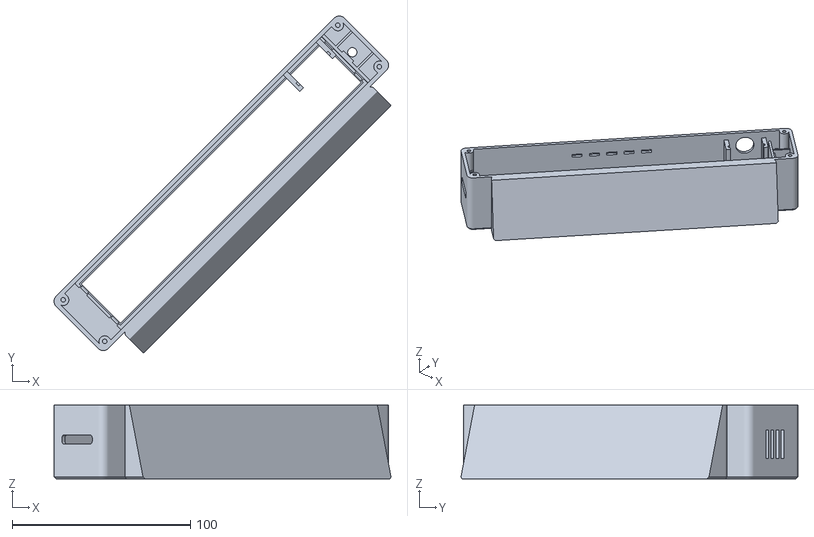
[picture p70: CAD file, 2026-10-05]
hardware/enclosure/stl/6-modules-plus/esp32-s3/shell-button.stl
189.1 x 189.1 x 41.5
