ElectroIoT/DotGlow-ESP32/(list of files, cad)

Other CAD files:
hardware/enclosure/stl/6-modules-plus/esp8266-d1-mini/shell-no-button.stl
hardware/enclosure/stl/6-modules-plus/esp8266-nodemcu-v2/shell-no-button.stl
hardware/enclosure/stl/6-modules-plus/esp32-devkit-30pin/shell-snap-no-button.stl
hardware/enclosure/stl/6-modules-plus/esp32-devkit-38pin/shell-snap-no-button.stl
hardware/enclosure/stl/6-modules-plus/esp32-s3/shell-snap-button.stl
hardware/enclosure/stl/6-modules-plus/esp8266-d1-mini/back.stl
hardware/enclosure/stl/6-modules-plus/esp8266-nodemcu-v2/shell-button.stl
hardware/enclosure/stl/6-modules-plus/esp8266-nodemcu-v3/shell-button.stl
hardware/enclosure/stl/variants/dotglow-shell-lean30.stl
hardware/enclosure/stl/6-modules-plus/esp32-devkit-30pin/shell-snap-button.stl
hardware/enclosure/stl/6-modules-plus/esp32-devkit-38pin/shell-button.stl
hardware/enclosure/stl/6-modules-plus/esp8266-d1-mini/shell-snap-no-button.stl
hardware/enclosure/stl/6-modules-plus/esp8266-nodemcu-v2/shell-snap-button.stl
hardware/enclosure/stl/extras/esp32-s3-back-tape.stl
hardware/enclosure/stl/6-modules-plus/esp32-devkit-30pin/back.stl
hardware/enclosure/stl/6-modules-plus/esp32-devkit-38pin/shell-no-button.stl
hardware/enclosure/stl/6-modules-plus/esp8266-nodemcu-v2/back-snap.stl
hardware/enclosure/stl/6-modules-plus/esp8266-nodemcu-v3/back.stl
hardware/enclosure/stl/6-modules-plus/esp32-devkit-30pin/back-snap.stl
hardware/enclosure/stl/6-modules-plus/esp32-devkit-38pin/shell-snap-button.stl
hardware/enclosure/stl/6-modules-plus/esp8266-d1-mini/shell-snap-button.stl
hardware/enclosure/stl/6-modules-plus/esp8266-nodemcu-v2/shell-snap-no-button.stl
hardware/enclosure/stl/6-modules-plus/esp8266-nodemcu-v3/shell-no-button.stl
hardware/enclosure/stl/6-modules-plus/esp32-devkit-30pin/shell-button.stl
hardware/enclosure/stl/6-modules-plus/esp32-devkit-38pin/back-snap.stl
hardware/enclosure/stl/6-modules-plus/esp8266-d1-mini/shell-button.stl
hardware/enclosure/stl/6-modules-plus/esp8266-nodemcu-v2/back.stl
hardware/enclosure/stl/6-modules-plus/esp8266-nodemcu-v3/shell-snap-no-button.stl
hardware/enclosure/stl/6-modules/esp32-devkit-30pin/back-snap.stl
hardware/enclosure/stl/6-modules/esp32-devkit-30pin/back.stl
hardware/enclosure/stl/6-modules/esp32-devkit-30pin/shell-button.stl
hardware/enclosure/stl/6-modules/esp32-devkit-30pin/shell-no-button.stl
hardware/enclosure/stl/6-modules/esp32-devkit-30pin/shell-snap-button.stl
hardware/enclosure/stl/6-modules/esp32-devkit-30pin/shell-snap-no-button.stl
hardware/enclosure/stl/6-modules/esp32-devkit-38pin/back-snap.stl
hardware/enclosure/stl/6-modules/esp32-devkit-38pin/back.stl
hardware/enclosure/stl/6-modules/esp32-devkit-38pin/shell-button.stl
hardware/enclosure/stl/6-modules/esp32-devkit-38pin/shell-no-button.stl
hardware/enclosure/stl/6-modules/esp32-devkit-38pin/shell-snap-button.stl
hardware/enclosure/stl/6-modules/esp32-devkit-38pin/shell-snap-no-button.stl
hardware/enclosure/stl/6-modules/esp32-s3/back-snap.stl
hardware/enclosure/stl/6-modules/esp32-s3/back.stl
hardware/enclosure/stl/6-modules/esp32-s3/shell-button.stl
hardware/enclosure/stl/6-modules/esp32-s3/shell-no-button.stl
hardware/enclosure/stl/6-modules/esp32-s3/shell-snap-button.stl
hardware/enclosure/stl/6-modules/esp32-s3/shell-snap-no-button.stl
hardware/enclosure/stl/6-modules/esp8266-d1-mini/back-snap.stl
hardware/enclosure/stl/6-modules/esp8266-d1-mini/back.stl
hardware/enclosure/stl/6-modules/esp8266-d1-mini/shell-button.stl
hardware/enclosure/stl/6-modules/esp8266-d1-mini/shell-no-button.stl
hardware/enclosure/stl/6-modules/esp8266-d1-mini/shell-snap-button.stl
hardware/enclosure/stl/6-modules/esp8266-d1-mini/shell-snap-no-button.stl
hardware/enclosure/stl/6-modules/esp8266-nodemcu-v2/back-snap.stl
hardware/enclosure/stl/6-modules/esp8266-nodemcu-v2/back.stl
hardware/enclosure/stl/6-modules/esp8266-nodemcu-v2/shell-button.stl
hardware/enclosure/stl/6-modules/esp8266-nodemcu-v2/shell-no-button.stl
hardware/enclosure/stl/6-modules/esp8266-nodemcu-v2/shell-snap-button.stl
hardware/enclosure/stl/6-modules/esp8266-nodemcu-v2/shell-snap-no-button.stl
hardware/enclosure/stl/6-modules/esp8266-nodemcu-v3/back-snap.stl
hardware/enclosure/stl/6-modules/esp8266-nodemcu-v3/back.stl
hardware/enclosure/stl/6-modules/esp8266-nodemcu-v3/shell-button.stl
hardware/enclosure/stl/6-modules/esp8266-nodemcu-v3/shell-no-button.stl
hardware/enclosure/stl/6-modules/esp8266-nodemcu-v3/shell-snap-button.stl
hardware/enclosure/stl/6-modules/esp8266-nodemcu-v3/shell-snap-no-button.stl
hardware/enclosure/stl/esp32-devkit-30pin/back-snap.stl
hardware/enclosure/stl/esp32-devkit-30pin/back.stl
hardware/enclosure/stl/esp32-devkit-30pin/shell-button.stl
hardware/enclosure/stl/esp32-devkit-30pin/shell-no-button.stl
hardware/enclosure/stl/esp32-devkit-30pin/shell-snap-button.stl
hardware/enclosure/stl/esp32-devkit-30pin/shell-snap-no-button.stl
hardware/enclosure/stl/esp32-devkit-38pin/back-snap.stl
hardware/enclosure/stl/esp32-devkit-38pin/back.stl
hardware/enclosure/stl/esp32-devkit-38pin/shell-button.stl
hardware/enclosure/stl/esp32-devkit-38pin/shell-no-button.stl
hardware/enclosure/stl/esp32-devkit-38pin/shell-snap-button.stl
hardware/enclosure/stl/esp32-devkit-38pin/shell-snap-no-button.stl
hardware/enclosure/stl/esp32-s3/back-snap.stl
hardware/enclosure/stl/esp32-s3/back.stl
hardware/enclosure/stl/esp32-s3/shell-button.stl
hardware/enclosure/stl/esp32-s3/shell-no-button.stl
hardware/enclosure/stl/esp32-s3/shell-snap-button.stl
hardware/enclosure/stl/esp32-s3/shell-snap-no-button.stl
hardware/enclosure/stl/esp8266-d1-mini/back-snap.stl
hardware/enclosure/stl/esp8266-d1-mini/back.stl
hardware/enclosure/stl/esp8266-d1-mini/shell-button.stl
hardware/enclosure/stl/esp8266-d1-mini/shell-no-button.stl
hardware/enclosure/stl/esp8266-d1-mini/shell-snap-button.stl
hardware/enclosure/stl/esp8266-d1-mini/shell-snap-no-button.stl
hardware/enclosure/stl/esp8266-nodemcu-v2/back-snap.stl
hardware/enclosure/stl/esp8266-nodemcu-v2/back.stl
hardware/enclosure/stl/esp8266-nodemcu-v2/shell-button.stl
hardware/enclosure/stl/esp8266-nodemcu-v2/shell-no-button.stl
hardware/enclosure/stl/esp8266-nodemcu-v2/shell-snap-button.stl
hardware/enclosure/stl/esp8266-nodemcu-v2/shell-snap-no-button.stl
hardware/enclosure/stl/esp8266-nodemcu-v3/back-snap.stl
hardware/enclosure/stl/esp8266-nodemcu-v3/back.stl
hardware/enclosure/stl/esp8266-nodemcu-v3/shell-button.stl
hardware/enclosure/stl/esp8266-nodemcu-v3/shell-no-button.stl
hardware/enclosure/stl/esp8266-nodemcu-v3/shell-snap-button.stl
hardware/enclosure/stl/esp8266-nodemcu-v3/shell-snap-no-button.stl
