ElectroIoT/DotGlow-ESP32/hardware/pcb/easyeda/dotglow-v1-schematic.pdf

# Microcontroller

# Stopwatch

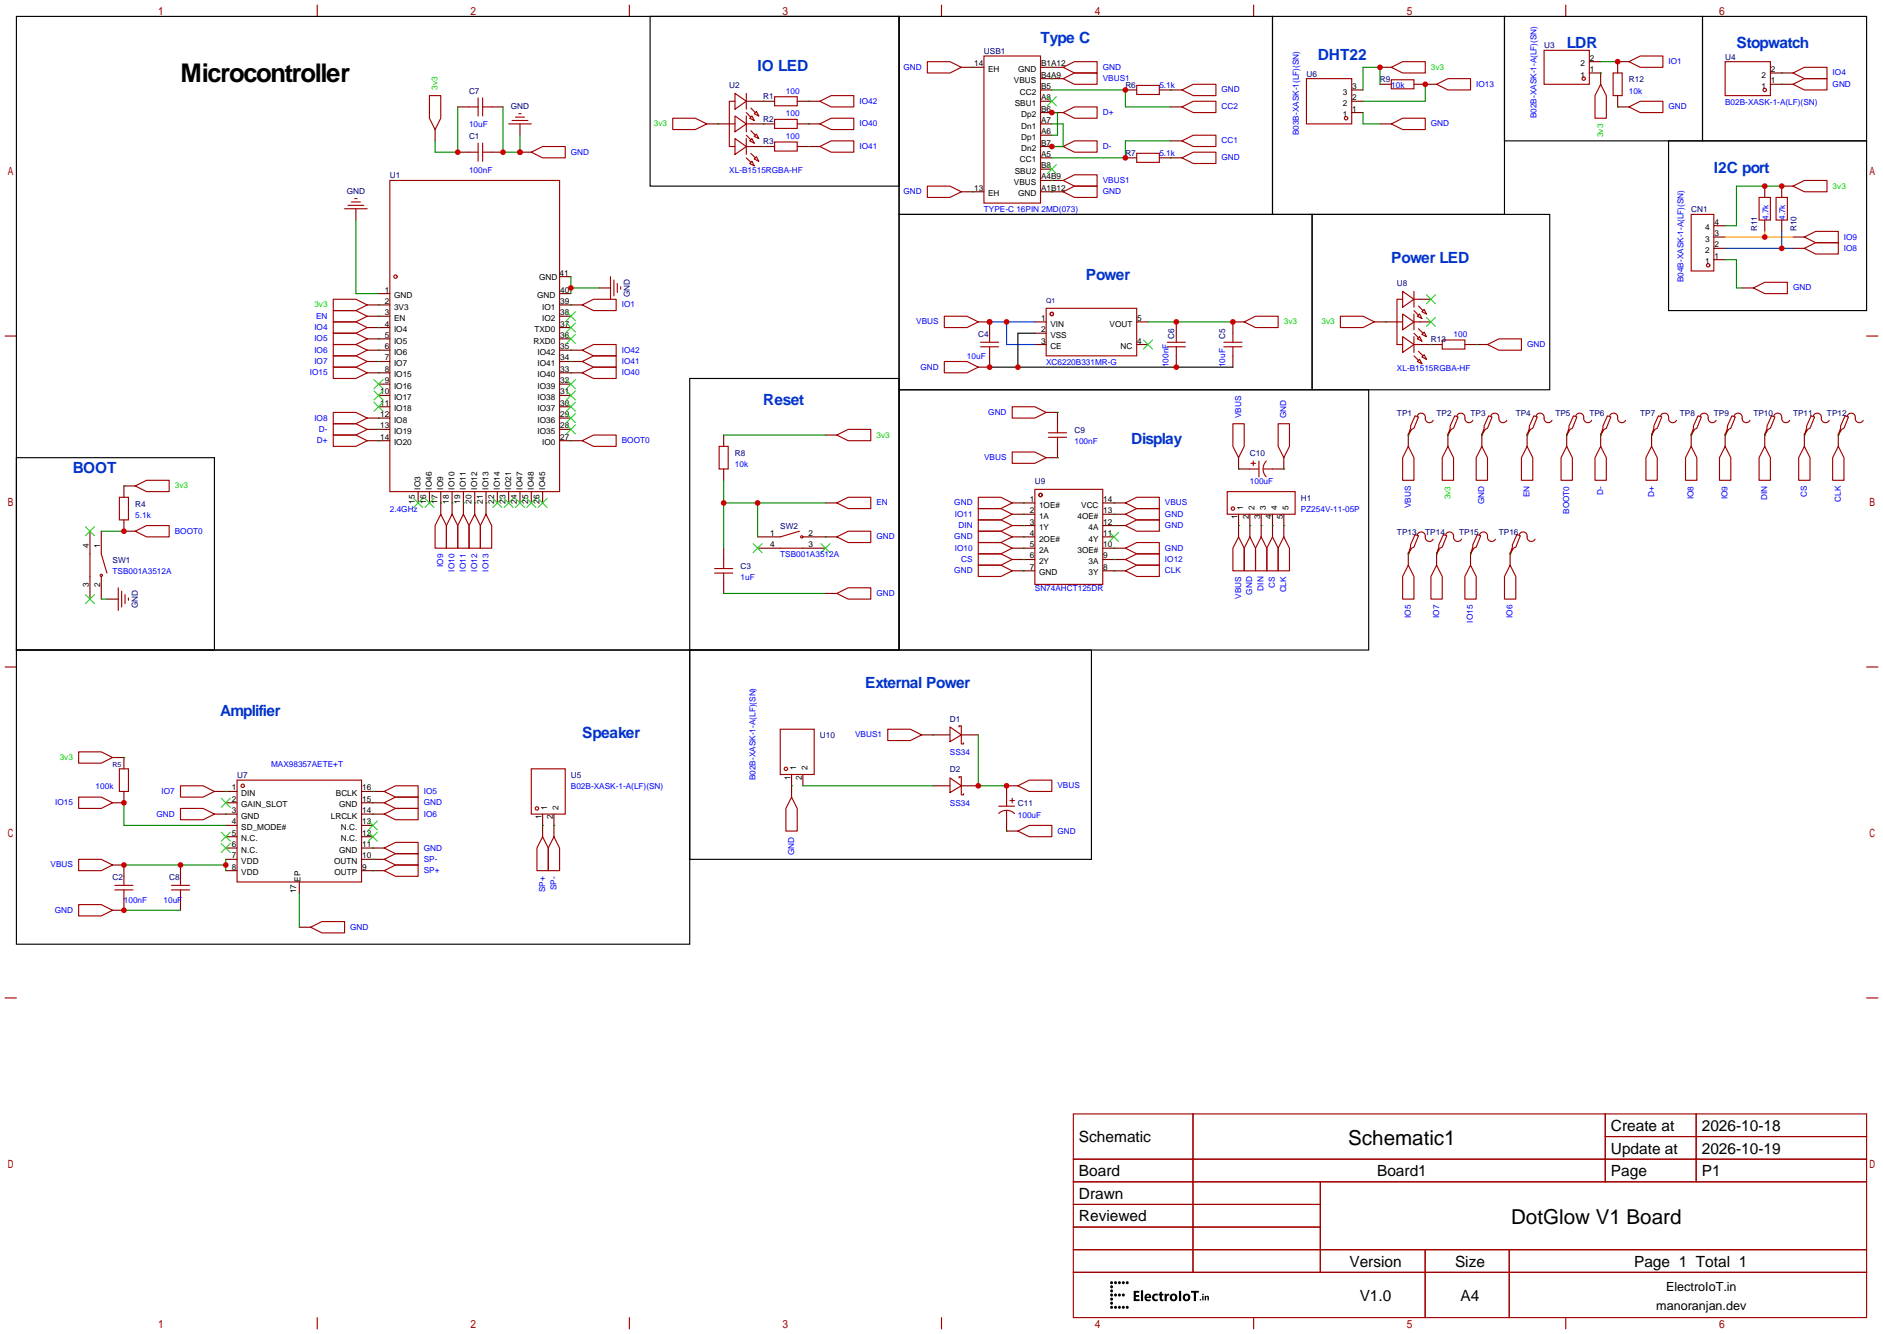
[picture p72: page 1]

MAX98357AETE+T
OUTN 10 GND 11 N.C. 12 N.C. 13 LRCLK 14 GND 15 BCLK 16

Schematic | Schematic1 | Create at | 2026-10-18

Update at | 2026-10-19

Board | Board1 | Page | P1
Drawn | | DotGlow V1 Board
Reviewed

Version | Size | Page 1 Total 1
V1.0 | | A4 | ElectroIoT.in manoranjan.dev
