ElectroIoT/DotGlow-ESP32/hardware/pcb/renders/schematic.pdf

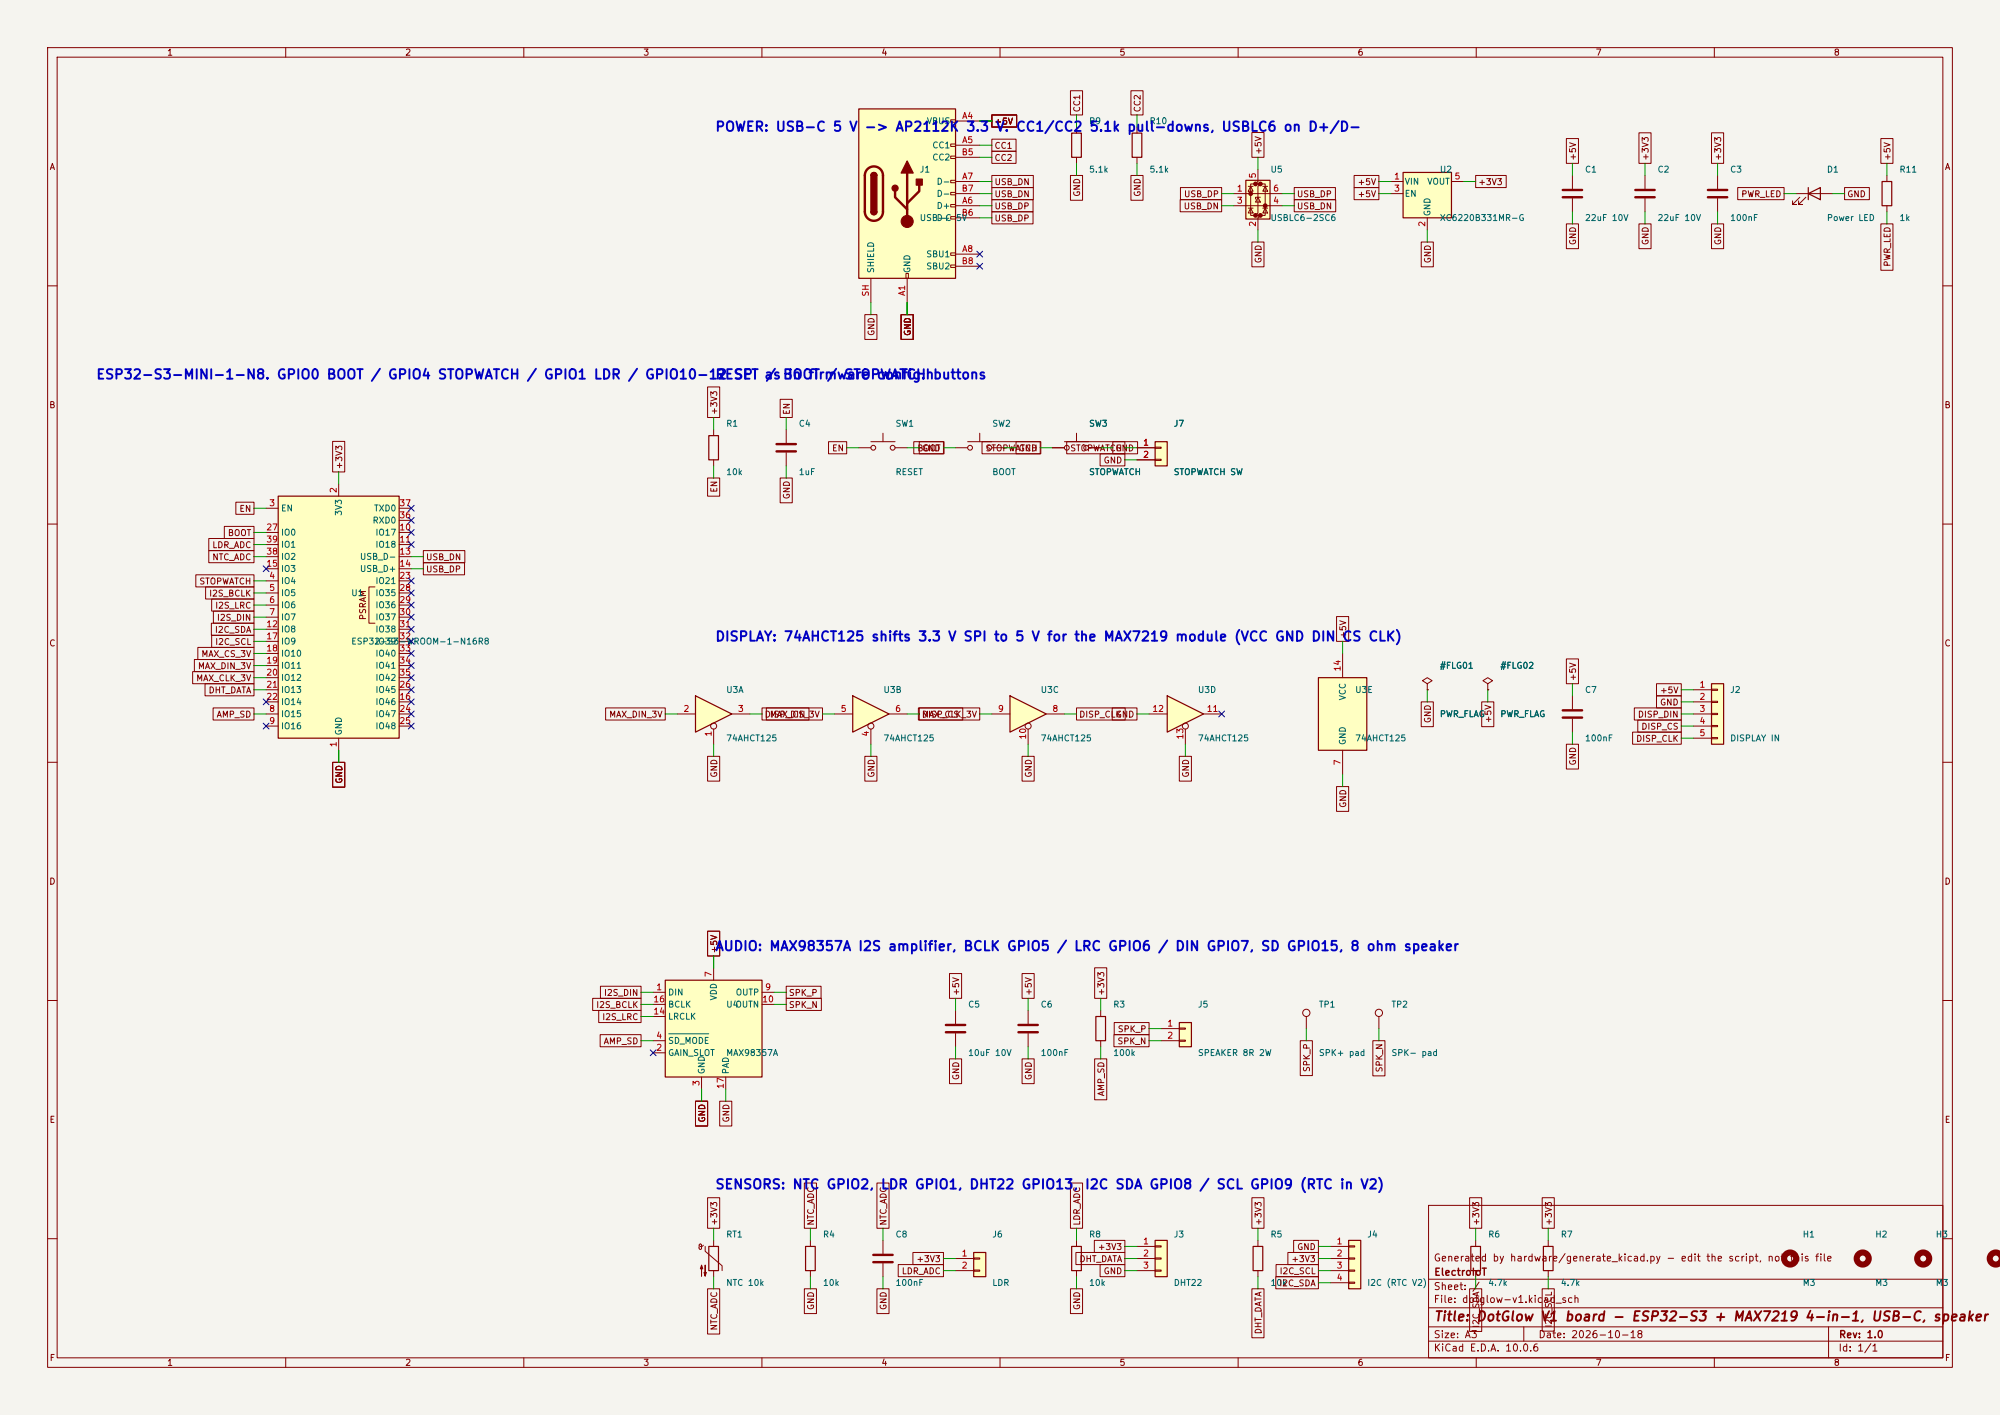
[picture p77: page 1]

ESP32-S3-MINI-1-N8. GPIO0 BOOT / GPIO4 STOPWATCH / GPIO1 LDR / GPIO10-12 SPI as in firmware config.h

RESET / BOOT / STOPWATCH buttons

Generated by hardware/generate_kicad.py - edit the script, not this file PSRAM GND

AUDIO: MAX98357A I2S amplifier, BCLK GPIO5 / LRC GPIO6 / DIN GPIO7, SD GPIO15, 8 ohm speaker

ElectroIoT
Sheet: /
File: dotglow-v1.kicad_sch
Title: DotGlow V1 board - ESP32-S3 + MAX7219 4-in-1, USB-C, speaker

Size: A3 | Rev: 1.0 | F Date: 2026-10-18
KiCad E.D.A. 10.0.6 | Id: 1/1
