ElectroIoT/DotGlow-ESP32/hardware/pcb/layout/dotglow-v1-layout.pdf

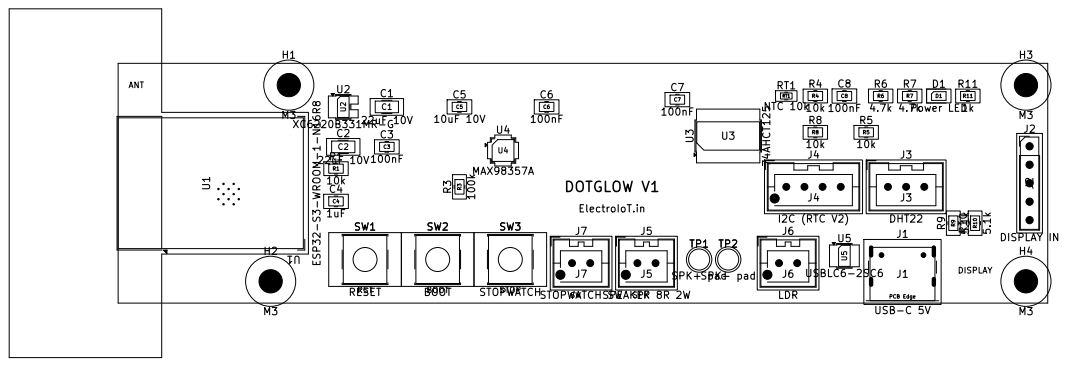
[picture p78: page 1]

DISPLAY ElectroIoT.in DOTGLOW V1
