ElectroIoT/DotGlow-ESP32/hardware/pcb/layout/kicad/dotglow-v1.kicad_pcb

## KiCad design hardware/pcb/layout/kicad/dotglow-v1.kicad_pcb (2026-10-20)

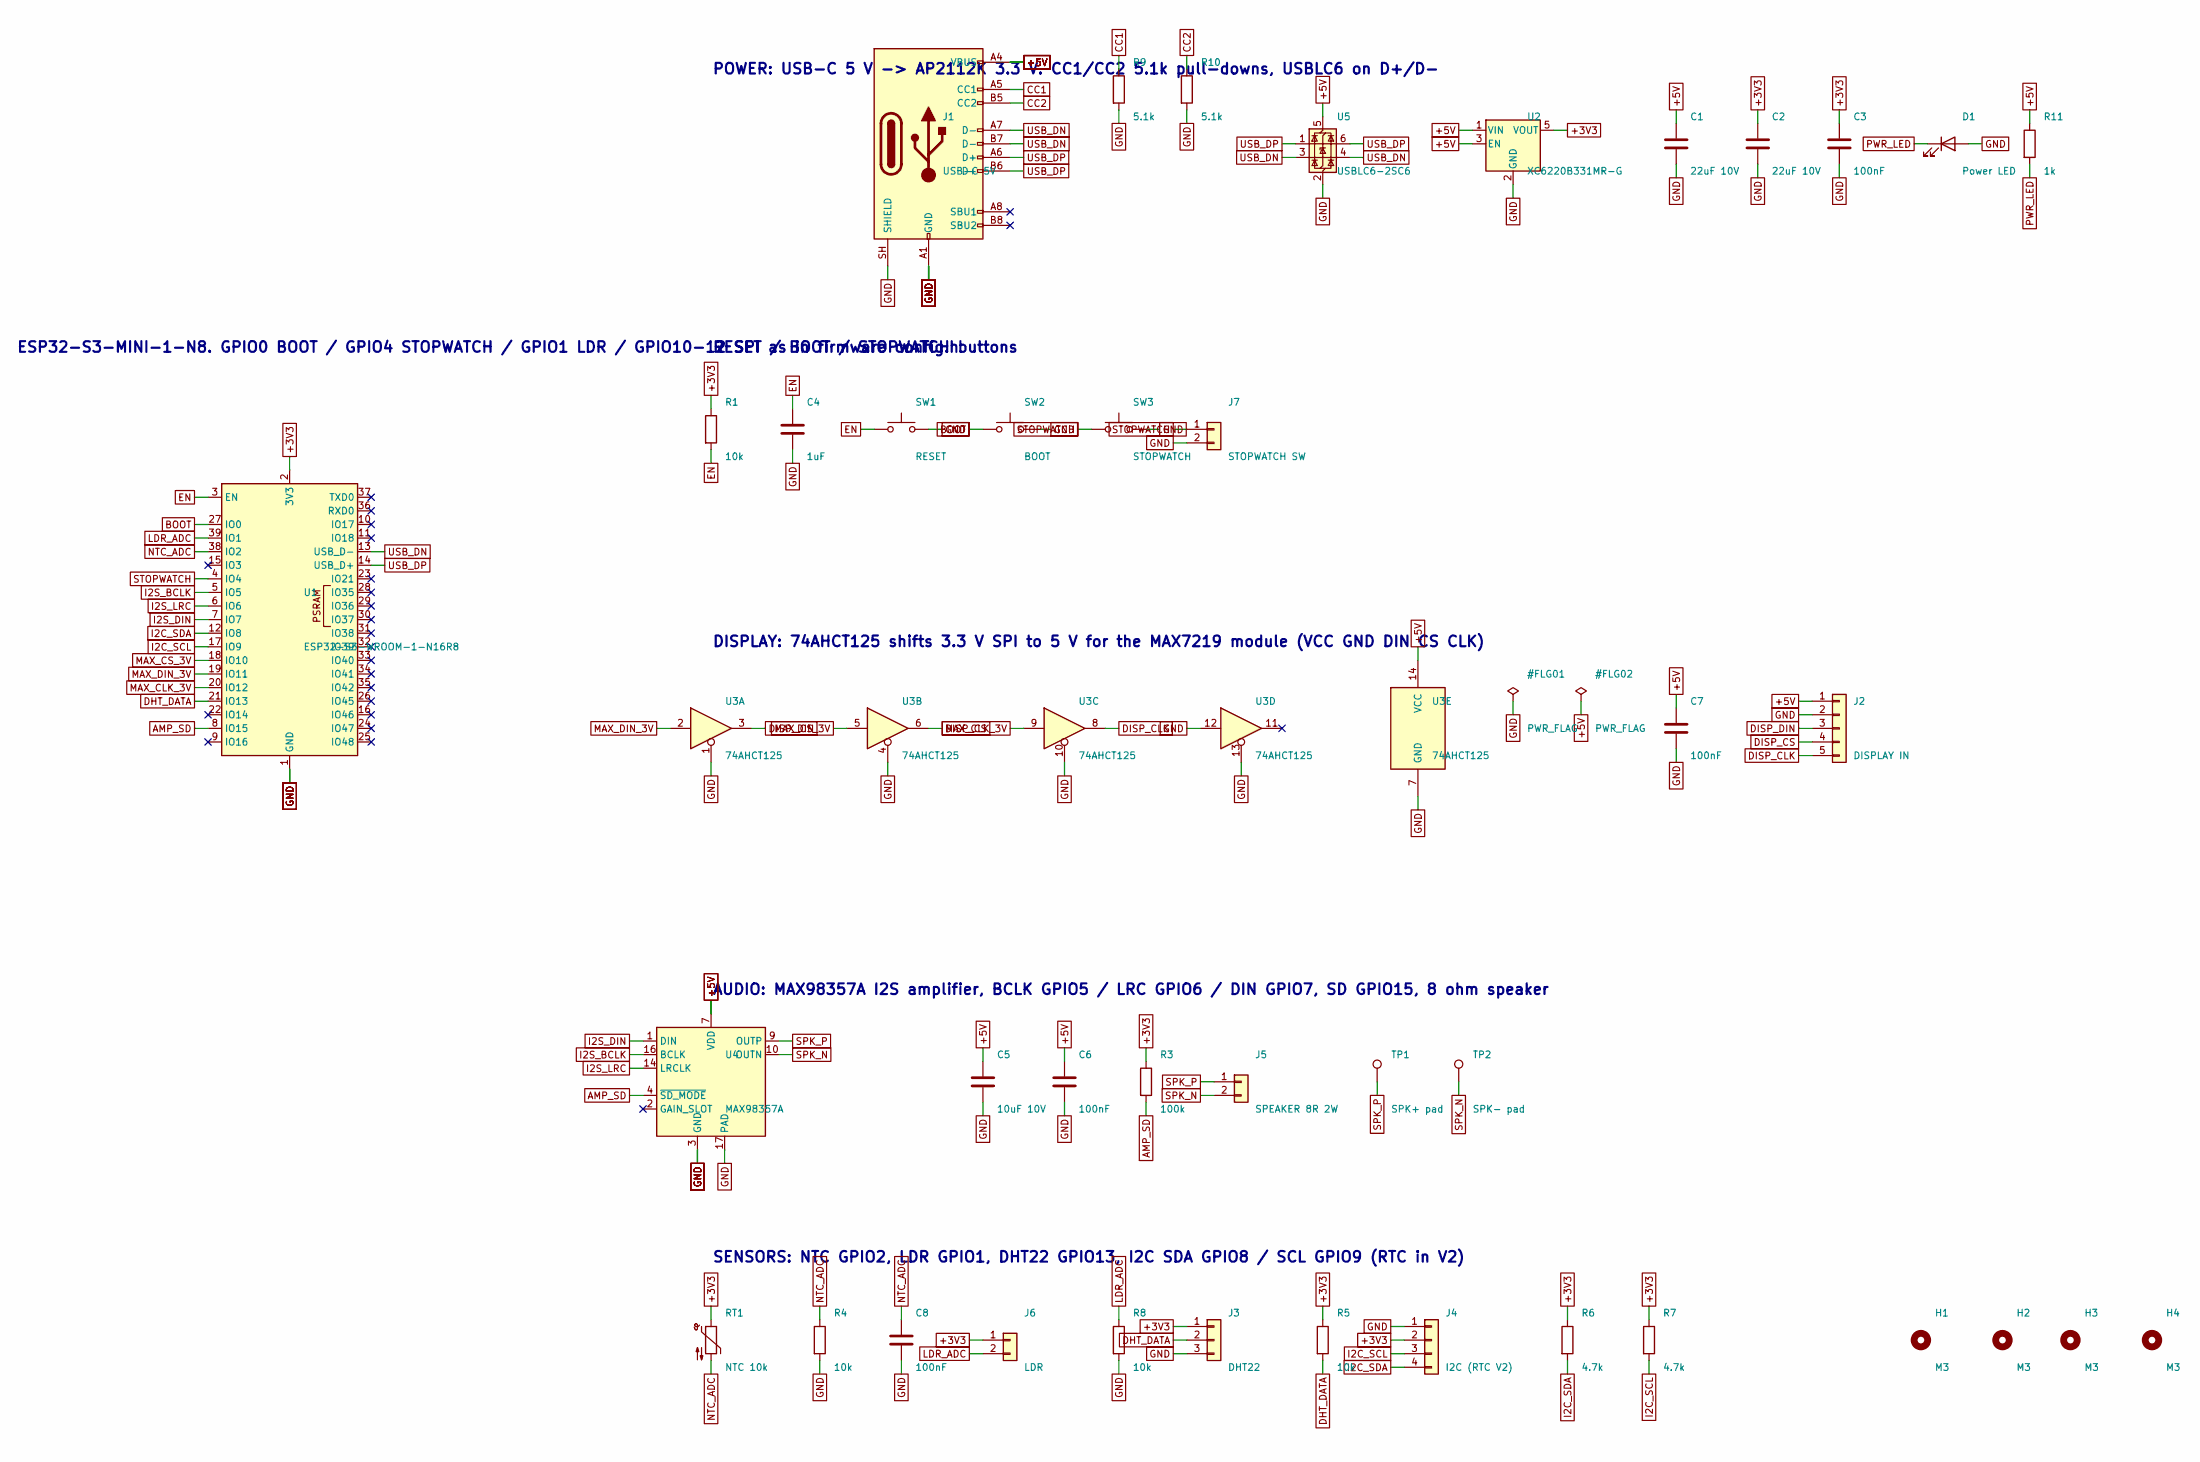
[picture p79: schematic dotglow-v1.kicad_sch, DotGlow V1 board - ESP32-S3 + MAX7219 4-in-1, USB-C, speaker]

Parts:
C1, C2: 22uF 10V; C_1206_3216Metric
C3, C6, C7, C8: 100nF; C_0805_2012Metric
C4: 1uF; C_0805_2012Metric
C5: 10uF 10V; C_0805_2012Metric
D1: Power LED; LED_0805_2012Metric
H1, H2, H3, H4: M3; MountingHole_3.2mm_M3
J1: USB-C 5V; USB_C_Receptacle_GCT_USB4105-xx-A_16P_TopMnt_Horizontal
J2: DISPLAY IN; PinHeader_1x05_P2.54mm_Vertical
J3: DHT22; JST_XA_B03B-XASK-1_1x03_P2.50mm_Vertical
J4: I2C (RTC V2); JST_XA_B04B-XASK-1-A_1x04_P2.50mm_Vertical
J5: SPEAKER 8R 2W; JST_XA_B02B-XASK-1-A_1x02_P2.50mm_Vertical
J6: LDR; JST_XA_B02B-XASK-1-A_1x02_P2.50mm_Vertical
J7: STOPWATCH SW; JST_XA_B02B-XASK-1-A_1x02_P2.50mm_Vertical
R1, R4, R5, R8: 10k; R_0805_2012Metric
R3: 100k; R_0805_2012Metric
R6, R7: 4.7k; R_0805_2012Metric
R9, R10: 5.1k; R_0805_2012Metric
R11: 1k; R_0805_2012Metric
RT1: NTC 10k; R_0603_1608Metric
SW1: RESET; SW_SPST_B3S-1000
SW2: BOOT; SW_SPST_B3S-1000
SW3: STOPWATCH; SW_SPST_B3S-1000
TP1: SPK+ pad; TestPoint_Pad_D2.5mm
TP2: SPK- pad; TestPoint_Pad_D2.5mm
U1: ESP32-S3-WROOM-1-N16R8; ESP32-S3-WROOM-1
U2: XC6220B331MR-G; SOT-23-5
U3: 74AHCT125; SOIC-14_3.9x8.7mm_P1.27mm
U4: MAX98357A; TQFN-16-1EP_3x3mm_P0.5mm_EP1.6x1.6mm
U5: USBLC6-2SC6; SOT-23-6

Connections:
+3V3: C2.1, C3.1, J3.1, J4.2, J6.1, R1.1, R3.1, R5.1, R6.1, R7.1, RT1.1, U1.2 (3V3), U2.5 (VOUT)
+5V: C1.1, C5.1, C6.1, C7.1, J1.A4 (VBUS), J1.A9 (VBUS), J1.B4 (VBUS), J1.B9 (VBUS), J2.1, R11.1, U2.1 (VIN), U2.3 (EN), U3.14 (VCC), U4.7 (VDD), U4.8 (VDD), U5.5 (VBUS)
AMP_SD: R3.2, U1.8 (IO15), U4.4 (~SD_MODE)
BOOT: SW2.1, U1.27 (IO0)
CC1: J1.A5 (CC1), R9.1
CC2: J1.B5 (CC2), R10.1
DHT_DATA: J3.2, R5.2, U1.21 (IO13)
DISP_CLK: J2.5, U3.8
DISP_CS: J2.4, U3.6
DISP_DIN: J2.3, U3.3
EN: C4.1, R1.2, SW1.1, U1.3 (EN)
GND: C1.2, C2.2, C3.2, C4.2, C5.2, C6.2, C7.2, C8.2, D1.2 (A), J1.A1 (GND), J1.A12 (GND), J1.B1 (GND), J1.B12 (GND), J1.SH (SHIELD), J2.2, J3.3, J4.1, J7.2, R4.2, R8.2, R9.2, R10.2, SW1.2, SW2.2, SW3.2, U1.1 (GND), U1.40 (GND), U1.41 (GND), U2.2 (GND), U3.1, U3.4, U3.7 (GND), U3.10, U3.12, U3.13, U4.3 (GND), U4.11 (GND), U4.15 (GND), U4.17 (PAD), U5.2 (GND)
I2C_SCL: J4.3, R7.2, U1.17 (IO9)
I2C_SDA: J4.4, R6.2, U1.12 (IO8)
I2S_BCLK: U1.5 (IO5), U4.16 (BCLK)
I2S_DIN: U1.7 (IO7), U4.1 (DIN)
I2S_LRC: U1.6 (IO6), U4.14 (LRCLK)
LDR_ADC: J6.2, R8.1, U1.39 (IO1)
MAX_CLK_3V: U1.20 (IO12), U3.9
MAX_CS_3V: U1.18 (IO10), U3.5
MAX_DIN_3V: U1.19 (IO11), U3.2
NTC_ADC: C8.1, R4.1, RT1.2, U1.38 (IO2)
PWR_LED: D1.1 (K), R11.2
SPK_N: J5.2, TP2.1, U4.10 (OUTN)
SPK_P: J5.1, TP1.1, U4.9 (OUTP)
STOPWATCH: J7.1, SW3.1, U1.4 (IO4)
USB_DN: J1.A7 (D-), J1.B7 (D-), U1.13 (USB_D-), U5.3 (I/O2), U5.4 (I/O2)
USB_DP: J1.A6 (D+), J1.B6 (D+), U1.14 (USB_D+), U5.1 (I/O1), U5.6 (I/O1)

Notes on the sheet:
POWER: USB-C 5 V -> AP2112K 3.3 V. CC1/CC2 5.1k pull-downs, USBLC6 on D+/D-
ESP32-S3-MINI-1-N8. GPIO0 BOOT / GPIO4 STOPWATCH / GPIO1 LDR / GPIO10-12 SPI as in firmware config.h
RESET / BOOT / STOPWATCH buttons
DISPLAY: 74AHCT125 shifts 3.3 V SPI to 5 V for the MAX7219 module (VCC GND DIN CS CLK)
AUDIO: MAX98357A I2S amplifier, BCLK GPIO5 / LRC GPIO6 / DIN GPIO7, SD GPIO15, 8 ohm speaker
SENSORS: NTC GPIO2, LDR GPIO1, DHT22 GPIO13, I2C SDA GPIO8 / SCL GPIO9 (RTC in V2)

Board: 2 copper layers, 41 parts (0 on the bottom side), 28 nets, no tracks yet.
