ElectroIoT/DotGlow-ESP32/src/github_roots.h

// Root certificates trusted for firmware downloads from GitHub.
// github.com chains to Sectigo E46 / USERTrust ECC; release assets are served from
// *.githubusercontent.com, which chains to ISRG Root X1 (Let's Encrypt). The others are
// backups in case GitHub changes certificate authority.
// Source: Git for Windows CA bundle (mingw64/etc/ssl/certs/ca-bundle.crt).
// Included: USERTrust ECC Certification Authority, Sectigo Public Server Authentication Root E46, ISRG Root X1, ISRG Root X2, USERTrust RSA Certification Authority, Sectigo Public Server Authentication Root R46, DigiCert Global Root G2.
#pragma once

static const char GITHUB_ROOTS[] = R"PEM(
-----BEGIN CERTIFICATE-----
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
-----END CERTIFICATE-----
-----BEGIN CERTIFICATE-----
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
-----END CERTIFICATE-----
-----BEGIN CERTIFICATE-----
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
-----END CERTIFICATE-----
-----BEGIN CERTIFICATE-----
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
/q4AaOeMSQ+2b1tbFfLn
-----END CERTIFICATE-----
-----BEGIN CERTIFICATE-----
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
jjxDah2nGN59PRbxYvnKkKj9
-----END CERTIFICATE-----
-----BEGIN CERTIFICATE-----
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
-----END CERTIFICATE-----
-----BEGIN CERTIFICATE-----
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
MrY=
-----END CERTIFICATE-----
)PEM";
