ElectroIoT/DotGlow-ESP32/src/display.h

// Frame buffer (8 px high, 32..128 px wide), text, clock face and animations on top of MD_MAX72XX
#pragma once

#include <Arduino.h>
#include <time.h>

extern int W;              // display width in pixels: 8 x number of modules (set by displayBegin)
static const int H = 8;    // display height in pixels
static const int MAX_W = 128;

// Provided by main.cpp: waits while keeping WiFi / web server responsive.
void serviceWait(uint32_t ms);

// ---- low level ----------------------------------------------------------------
void displayBegin();                    // after settingsLoad(): module count / type come from settings
void showModuleNumbers();
void drawPasskey(uint32_t pk);           // 6-digit Bluetooth pairing PIN, centred (one frame)               // numbers each 8x8 module, to check the chain order
void drawStopwatch(uint32_t ms, bool running);   // stopwatch face (one frame)
void drawProgress(uint8_t percent);      // update progress: percentage + bar (one frame)
void displayIntensity(uint8_t level);   // 0..15
void displayPower(bool on);
void fbClear();
void fbSet(int x, int y, bool on);      // x: 0 = left, y: 0 = top; out-of-range is ignored
void fbShow();                          // push the frame buffer to the modules

// ---- text (library system font) ------------------------------------------------
int  textWidth(const String& s);
void drawText(int x, const String& s);  // left edge at x, clipped to the display
void scrollText(const String& s);       // blocking right-to-left scroll across the display

// Non-blocking scroller: call step() once per frame, returns true after one full pass.
struct Marquee {
    String text;
    int    pos = 0;
    void   start(const String& s) { text = s; pos = 0; }
    bool   step();
};

// ---- clock face -----------------------------------------------------------------
struct ClockFace {
    void reset();                                        // next draw shows digits without animating
    void demo();                                         // animate all digits once (preview on the web page)
    void draw(const struct tm& t, uint16_t ms, int dx);  // dx shifts the face horizontally (slide transitions)
    void tick();                                         // advance digit animations, once per frame
private:
    void    drawSlot(int i, int x);
    static const int SLOTS = 6;   // H H M M S S
    uint8_t cur[SLOTS]   = {0};
    uint8_t prev[SLOTS]  = {0};
    uint8_t phase[SLOTS] = {0};   // frames of the change animation left, 0 = settled
    uint8_t style = 0;        // Roll style of the running animation (a fixed pick when set to Random)
    bool    fresh = true;
    bool    demoPending = false;
};

// ---- animations (blocking, ~2-4 s) ---------------------------------------------
void playAnim(uint8_t anim);            // Anim value; ANIM_RANDOM picks one
void spinnerFrame(uint16_t n);          // one frame of a "working..." bouncing bar
