ElectroIoT/DotGlow-ESP32/src/app.h

// State shared between the main loop (main.cpp) and the web handlers (web.cpp)
#pragma once

#include <Arduino.h>

enum AppMode : uint8_t { MODE_CLOCK, MODE_SETUP, MODE_SAFE };

extern AppMode  appMode;
extern String   apName;          // setup hotspot name, e.g. "DotGlow-EEA8"
extern uint8_t  animRequest;     // Anim to play on the next loop pass (ANIM_OFF = none)
extern String   scrollRequest;   // text to scroll on the next loop pass (empty = none)
extern uint32_t restartAt;       // millis() at which to restart, 0 = never
extern bool     digitDemo;       // play the digit change animation once, as a preview
extern bool     moduleTest;      // show each module's number once (web page, Display card)
enum OtaRequest : uint8_t { OTA_NONE, OTA_CHECK, OTA_INSTALL };
extern uint8_t  otaRequest;      // GitHub update work for the main loop (needs TLS, too slow for a web handler)

uint16_t chipId16();                   // last 2 bytes of the MAC, e.g. hotspot "DotGlow-EEA8"
bool timeValid();                      // true once NTP has delivered a real time
void applyBrightness(bool force);      // day / night / light-sensor brightness from settings
int  lightPercent();                   // light sensor reading 0..100, -1 = sensor off
uint8_t brightnessNow();               // brightness currently on the display (16 = off)
void startNtp();                       // (re)start SNTP with the configured time zone
void scheduleRestart(uint32_t delayMs);
void showEventsToday();                // queue today's special-day animation + text, if any
