ElectroIoT/DotGlow-ESP32/tools/make_images.py

"""Generate the README images in docs/ (animated SVG, no external assets).

The LED graphics use the same 5x7 digits, layout and sprites as the firmware
(src/display.cpp), so the pictures match what the real clock shows.

    python tools/make_images.py
"""
import os

OUT = os.path.join(os.path.dirname(__file__), '..', 'docs')
os.makedirs(OUT, exist_ok=True)

RED, OFF, PANEL = '#ff3b3b', '#2b0d0d', '#0b0b0d'
FONT = "font-family='Segoe UI,Roboto,Helvetica,Arial,sans-serif'"

# ---- same data as src/display.cpp ------------------------------------------------
DIGITS = {
    0: [0x0E, 0x11, 0x13, 0x15, 0x19, 0x11, 0x0E], 1: [0x04, 0x0C, 0x04, 0x04, 0x04, 0x04, 0x0E],
    2: [0x0E, 0x11, 0x01, 0x02, 0x04, 0x08, 0x1F], 3: [0x1F, 0x02, 0x04, 0x02, 0x01, 0x11, 0x0E],
    4: [0x02, 0x06, 0x0A, 0x12, 0x1F, 0x02, 0x02], 5: [0x1F, 0x10, 0x1E, 0x01, 0x01, 0x11, 0x0E],
    6: [0x06, 0x08, 0x10, 0x1E, 0x11, 0x11, 0x0E], 7: [0x1F, 0x01, 0x02, 0x04, 0x08, 0x08, 0x08],
    8: [0x0E, 0x11, 0x11, 0x0E, 0x11, 0x11, 0x0E], 9: [0x0E, 0x11, 0x11, 0x0F, 0x01, 0x02, 0x0C],
}
DIGIT_X = [2, 8, 19, 25]
COLON_X = 15
PAC_OPEN = [0x1C, 0x3E, 0x78, 0x70, 0x78, 0x3E, 0x1C]
PAC_CLOSED = [0x1C, 0x3E, 0x7F, 0x7F, 0x7F, 0x3E, 0x1C]
GHOST = [0x1C, 0x3E, 0x6B, 0x7F, 0x7F, 0x7F, 0x55]


def digit_px(d):
    return [(c, r) for r in range(7) for c in range(5) if DIGITS[d][r] & (0x10 >> c)]


def sprite_px(rows):
    return [(c, r) for r in range(7) for c in range(7) if rows[r] & (0x40 >> c)]


class Matrix:
    """32x8 LED matrix drawn at (x0, y0) with dot pitch p."""

    def __init__(self, x0, y0, p=14):
        self.x0, self.y0, self.p = x0, y0, p

    def cx(self, x):
        return self.x0 + x * self.p + self.p / 2

    def cy(self, y):
        return self.y0 + y * self.p + self.p / 2

    def w(self):
        return 32 * self.p

    def h(self):
        return 8 * self.p

    def dot(self, x, y, extra='', fill=RED):
        return f"<circle cx='{self.cx(x):g}' cy='{self.cy(y):g}' r='{self.p * 0.36:g}' fill='{fill}'{extra}/>"

    def background(self, pad=14):
        s = [f"<rect x='{self.x0 - pad}' y='{self.y0 - pad}' width='{self.w() + 2 * pad}' height='{self.h() + 2 * pad}' rx='14' fill='{PANEL}' stroke='#26262c'/>"]
        s += [self.dot(x, y, fill=OFF) for y in range(8) for x in range(32)]
        return '\n'.join(s)


GLOW = """<filter id='glow' x='-50%' y='-50%' width='200%' height='200%'>
<feGaussianBlur stdDeviation='2.2' result='b'/><feMerge><feMergeNode in='b'/><feMergeNode in='SourceGraphic'/></feMerge></filter>"""


# ---- banner: clock rolling 12:45 -> 12:46, blinking colon, seconds bar ---------------
def banner():
    W, H = 900, 330
    m = Matrix((W - 32 * 16) / 2, 52, 16)
    dur = 6.0
    s = [f"<svg xmlns='http://www.w3.org/2000/svg' viewBox='0 0 {W} {H}' width='{W}' height='{H}'>",
         f"<defs>{GLOW}<clipPath id='cell'><rect x='{m.x0 + 25 * m.p}' y='{m.y0}' width='{5 * m.p}' height='{7 * m.p}'/></clipPath>",
         "<linearGradient id='bg' x1='0' y1='0' x2='1' y2='1'><stop offset='0' stop-color='#15161c'/><stop offset='1' stop-color='#1d1015'/></linearGradient></defs>",
         f"<rect width='{W}' height='{H}' rx='20' fill='url(#bg)'/>",
         m.background(18), "<g filter='url(#glow)'>"]
    for i, d in enumerate([1, 2, 4]):                       # static digits 1 2 : 4
        s += [m.dot(DIGIT_X[i] + c, r) for c, r in digit_px(d)]
    # colon, blinking once per second
    s.append(f"<g><animate attributeName='opacity' values='1;0' dur='1s' calcMode='discrete' repeatCount='indefinite'/>")
    s += [m.dot(COLON_X + c, r) for c in (0, 1) for r in (1, 2, 4, 5)]
    s.append('</g>')
    # last digit rolls down from 5 to 6 at t = 3 s
    shift = 8 * m.p
    t1, t2 = 3.0 / dur, 3.4 / dur
    s.append("<g clip-path='url(#cell)'><g>")
    s.append(f"<animateTransform attributeName='transform' type='translate' values='0 0;0 0;0 {shift:g};0 {shift:g}' "
             f"keyTimes='0;{t1:.3f};{t2:.3f};1' dur='{dur}s' repeatCount='indefinite'/>")
    s += [m.dot(DIGIT_X[3] + c, r) for c, r in digit_px(5)]
    s += [m.dot(DIGIT_X[3] + c, r - 8) for c, r in digit_px(6)]
    s.append('</g></g>')
    # seconds bar on the bottom row, filling up over the loop
    for x in range(32):
        k = (x + 1) / 33
        s.append(f"<circle cx='{m.cx(x):g}' cy='{m.cy(7):g}' r='{m.p * 0.36:g}' fill='{RED}' opacity='0'>"
                 f"<animate attributeName='opacity' values='0;1' keyTimes='0;{k:.3f}' calcMode='discrete' dur='{dur}s' repeatCount='indefinite'/></circle>")
    s.append('</g>')
    s.append(f"<text x='{W / 2}' y='{H - 70}' text-anchor='middle' {FONT} font-size='38' font-weight='700' fill='#f2f3f7'>DotGlow</text>")
    s.append(f"<text x='{W / 2}' y='{H - 36}' text-anchor='middle' {FONT} font-size='18' fill='#9aa0ad'>"
             "ESP32 / ESP32-S3 LED matrix clock · Android app over Bluetooth · WiFi · animations</text>")
    s.append('</svg>')
    return '\n'.join(s)


# ---- pac-man strip ------------------------------------------------------------------
def pacman():
    m = Matrix(24, 24, 14)
    W, H = int(m.w() + 48), int(m.h() + 48)
    frames = 32 + 11 + 16          # pac-man from x=-8 until the ghost has left
    step = 0.09
    dur = frames * step
    s = [f"<svg xmlns='http://www.w3.org/2000/svg' viewBox='0 0 {W} {H}' width='{W}' height='{H}'>",
         f"<defs>{GLOW}<clipPath id='mx'><rect x='{m.x0}' y='{m.y0}' width='{m.w()}' height='{m.h()}'/></clipPath></defs>",
         m.background(16), "<g filter='url(#glow)' clip-path='url(#mx)'>"]

    def xs(offset):   # discrete x positions of a sprite for each frame
        return ';'.join(f"{(f - 8 + offset) * m.p:g} 0" for f in range(frames))

    for d in range(2, 32, 4):                  # dots, eaten when pac-man passes
        eat = min(max((d - 3 + 8) / frames, 0.001), 0.999)
        s.append(f"<circle cx='{m.cx(d):g}' cy='{m.cy(3):g}' r='{m.p * 0.36:g}' fill='{RED}'>"
                 f"<animate attributeName='opacity' values='1;0' keyTimes='0;{eat:.3f}' calcMode='discrete' dur='{dur:.2f}s' repeatCount='indefinite'/></circle>")
    for rows, phase in ((PAC_OPEN, '1;0'), (PAC_CLOSED, '0;1')):
        s.append(f"<g><animateTransform attributeName='transform' type='translate' values='{xs(0)}' calcMode='discrete' dur='{dur:.2f}s' repeatCount='indefinite'/>"
                 f"<animate attributeName='opacity' values='{phase}' dur='{step * 4:.2f}s' calcMode='discrete' repeatCount='indefinite'/>")
        s += [m.dot(c, r) for c, r in sprite_px(rows)]
        s.append('</g>')
    s.append(f"<g><animateTransform attributeName='transform' type='translate' values='{xs(-11)}' calcMode='discrete' dur='{dur:.2f}s' repeatCount='indefinite'/>")
    s += [m.dot(c, r) for c, r in sprite_px(GHOST)]
    s.append('</g></g></svg>')
    return '\n'.join(s)


# ---- wiring -------------------------------------------------------------------------
BOARDS = {
    'esp32s3': ('ESP32-S3', 'DevKitC-1', [('VCC', '5V', '#ff4d4d'), ('GND', 'GND', '#9aa0ad'), ('DIN', 'GPIO11', '#35d07f'),
                                          ('CS', 'GPIO10', '#ffc53d'), ('CLK', 'GPIO12', '#4da3ff')]),
    'esp32': ('ESP32', 'DevKit (WROOM-32)', [('VCC', 'VIN (5V)', '#ff4d4d'), ('GND', 'GND', '#9aa0ad'), ('DIN', 'GPIO23', '#35d07f'),
                                             ('CS', 'GPIO5', '#ffc53d'), ('CLK', 'GPIO18', '#4da3ff')]),
}


def wiring(key):
    name, sub, wires = BOARDS[key]
    W, H = 900, 400
    s = [f"<svg xmlns='http://www.w3.org/2000/svg' viewBox='0 0 {W} {H}' width='{W}' height='{H}'>",
         f"<rect width='{W}' height='{H}' rx='20' fill='#14161c'/>"]
    s.append("<rect x='50' y='70' width='230' height='270' rx='12' fill='#10353a' stroke='#1f6b72' stroke-width='2'/>")
    s.append("<rect x='120' y='40' width='90' height='42' rx='6' fill='#c9ccd4'/><rect x='140' y='52' width='50' height='18' rx='3' fill='#8b9099'/>")
    s.append("<rect x='95' y='110' width='140' height='90' rx='6' fill='#1e2126' stroke='#3a3f48'/>")
    s.append(f"<text x='165' y='150' text-anchor='middle' {FONT} font-size='19' font-weight='700' fill='#e8eaf0'>{name}</text>")
    s.append(f"<text x='165' y='174' text-anchor='middle' {FONT} font-size='12.5' fill='#9aa0ad'>{sub}</text>")
    s.append("<rect x='560' y='90' width='300' height='220' rx='12' fill='#12324f' stroke='#2a5d8a' stroke-width='2'/>")
    for i in range(4):
        x = 580 + i * 68
        s.append(f"<rect x='{x}' y='110' width='58' height='58' rx='4' fill='#0b0b0d'/>")
        for r in range(4):
            for c in range(4):
                s.append(f"<circle cx='{x + 9 + c * 13.3:.1f}' cy='{119 + r * 13.3:.1f}' r='4' fill='{RED if (r + c + i) % 3 == 0 else OFF}'/>")
    s.append(f"<text x='710' y='205' text-anchor='middle' {FONT} font-size='16' font-weight='700' fill='#e8eaf0'>MAX7219 4-in-1 (8x32)</text>")
    for i, (mod, esp, col) in enumerate(wires):
        y = 235 + i * 16
        ey = 225 + i * 22
        s.append(f"<circle cx='575' cy='{y}' r='5' fill='{col}'/>")
        s.append(f"<text x='590' y='{y + 5}' {FONT} font-size='13' fill='#e8eaf0'>{mod}</text>")
        s.append(f"<circle cx='265' cy='{ey}' r='5' fill='{col}'/>")
        s.append(f"<text x='252' y='{ey + 5}' text-anchor='end' {FONT} font-size='13' fill='#e8eaf0'>{esp}</text>")
        s.append(f"<path d='M270 {ey} C 420 {ey}, 420 {y}, 570 {y}' fill='none' stroke='{col}' stroke-width='3.5' stroke-linecap='round'>"
                 f"<animate attributeName='stroke-dasharray' values='0 400;400 0' dur='1.2s' begin='{i * 0.25}s' fill='freeze'/></path>")
    s.append(f"<text x='{W / 2}' y='375' text-anchor='middle' {FONT} font-size='14' fill='#9aa0ad'>"
             "5 V / 1 A supply · match the wire colours · the pin names are printed on both boards</text>")
    s.append('</svg>')
    return '\n'.join(s)


# ---- more modules: chaining, power supply, capacitors -------------------------------
def chain():
    W, H = 960, 560
    s = [f"<svg xmlns='http://www.w3.org/2000/svg' viewBox='0 0 {W} {H}' width='{W}' height='{H}'>",
         f"<rect width='{W}' height='{H}' rx='20' fill='#14161c'/>",
         f"<text x='{W / 2}' y='42' text-anchor='middle' {FONT} font-size='22' font-weight='700' fill='#f2f3f7'>"
         "Adding more modules (example: 8 modules = 8x64)</text>"]

    def board(x, y, label):
        s.append(f"<rect x='{x}' y='{y}' width='330' height='112' rx='10' fill='#12324f' stroke='#2a5d8a' stroke-width='2'/>")
        for i in range(4):
            bx = x + 12 + i * 78
            s.append(f"<rect x='{bx}' y='{y + 12}' width='70' height='70' rx='4' fill='#0b0b0d'/>")
            for r in range(5):
                for c in range(5):
                    lit = (r + 2 * c + i) % 4 == 0
                    s.append(f"<circle cx='{bx + 9 + c * 13:.1f}' cy='{y + 21 + r * 13:.1f}' r='4.2' fill='{RED if lit else OFF}'/>")
        s.append(f"<text x='{x + 165}' y='{y + 102}' text-anchor='middle' {FONT} font-size='13' fill='#cfd6e4'>{label}</text>")

    def cap(x, top, bottom):   # electrolytic capacitor from the 5 V rail (top) to the GND rail (bottom)
        mid = (top + bottom) / 2
        s.append(f"<line x1='{x}' y1='{top}' x2='{x}' y2='{mid - 8}' stroke='#ff4d4d' stroke-width='3'/>")
        s.append(f"<rect x='{x - 16}' y='{mid - 8}' width='32' height='5' fill='#e8eaf0'/>")
        s.append(f"<path d='M{x - 16} {mid + 6} Q {x} {mid - 2} {x + 16} {mid + 6}' fill='none' stroke='#e8eaf0' stroke-width='5'/>")
        s.append(f"<line x1='{x}' y1='{mid + 4}' x2='{x}' y2='{bottom}' stroke='#9aa0ad' stroke-width='3'/>")
        s.append(f"<text x='{x + 22}' y='{mid - 8}' {FONT} font-size='13' fill='#ffc53d'>+</text>")
        s.append(f"<text x='{x + 22}' y='{mid + 16}' {FONT} font-size='12' fill='#ffc53d'>1000 µF</text>")

    # boards: data enters board 1 on the right, leaves on the left into board 2
    board(80, 80, 'Board 2 (modules 5-8)')
    board(520, 80, 'Board 1 (modules 1-4)')
    s.append(f"<text x='855' y='150' {FONT} font-size='12' fill='#9aa0ad'>IN</text>")
    s.append(f"<text x='465' y='118' text-anchor='middle' {FONT} font-size='12' fill='#9aa0ad'>OUT → IN</text>")
    data = [('DOUT→DIN', '#35d07f', 128), ('CS', '#ffc53d', 140), ('CLK', '#4da3ff', 152)]
    for name, col, y in data:   # board 1 OUT -> board 2 IN
        s.append(f"<path d='M520 {y} L410 {y}' stroke='{col}' stroke-width='3.5' stroke-linecap='round'/>")

    # 5 V rail and ground rail under the boards
    s.append("<path d='M60 250 L900 250' stroke='#ff4d4d' stroke-width='6' stroke-linecap='round'/>")
    s.append("<path d='M60 330 L900 330' stroke='#9aa0ad' stroke-width='6' stroke-linecap='round'/>")
    s.append(f"<text x='66' y='240' {FONT} font-size='13' fill='#ff8080'>5 V</text>")
    s.append(f"<text x='66' y='352' {FONT} font-size='13' fill='#b8bdc8'>GND</text>")
    for bx in (245, 685):   # each board's VCC / GND tapped from the rails, with a capacitor at its input
        s.append(f"<path d='M{bx - 40} 192 L{bx - 40} 250' stroke='#ff4d4d' stroke-width='3.5'/>")
        s.append(f"<path d='M{bx + 40} 192 L{bx + 40} 330' stroke='#9aa0ad' stroke-width='3.5'/>")
        s.append(f"<text x='{bx - 36}' y='210' {FONT} font-size='11' fill='#cfd6e4'>VCC</text>")
        s.append(f"<text x='{bx + 44}' y='210' {FONT} font-size='11' fill='#cfd6e4'>GND</text>")
        cap(bx, 250, 330)

    # power supply
    s.append("<rect x='80' y='400' width='240' height='120' rx='12' fill='#262a33' stroke='#4a4f5b' stroke-width='2'/>")
    s.append(f"<text x='200' y='448' text-anchor='middle' {FONT} font-size='18' font-weight='700' fill='#f2f3f7'>5 V power supply</text>")
    s.append(f"<text x='200' y='474' text-anchor='middle' {FONT} font-size='13' fill='#9aa0ad'>2 A for 8 modules (see table)</text>")
    s.append("<path d='M150 400 L150 250' stroke='#ff4d4d' stroke-width='4'/><path d='M250 400 L250 330' stroke='#9aa0ad' stroke-width='4'/>")

    # controller board
    s.append("<rect x='600' y='400' width='280' height='120' rx='12' fill='#10353a' stroke='#1f6b72' stroke-width='2'/>")
    s.append(f"<text x='740' y='440' text-anchor='middle' {FONT} font-size='18' font-weight='700' fill='#f2f3f7'>ESP32 / ESP32-S3</text>")
    s.append(f"<text x='740' y='464' text-anchor='middle' {FONT} font-size='13' fill='#9aa0ad'>VIN from the 5 V rail, GND common</text>")
    s.append(f"<text x='740' y='500' text-anchor='middle' {FONT} font-size='13' fill='#cfd6e4'>DIN, CS and CLK as in the wiring picture</text>")
    s.append("<path d='M640 400 L640 250' stroke='#ff4d4d' stroke-width='3.5'/><path d='M670 400 L670 330' stroke='#9aa0ad' stroke-width='3.5'/>")
    for name, col, y in data:   # ESP -> board 1 IN (right end)
        x = {128: 930, 140: 918, 152: 906}[y]
        s.append(f"<path d='M880 {400 + (y - 128) * 2 + 20} L{x} {400 + (y - 128) * 2 + 20} L{x} {y} L852 {y}' fill='none' "
                 f"stroke='{col}' stroke-width='3.5' stroke-linejoin='round' stroke-linecap='round'/>")
    s.append('</svg>')
    return '\n'.join(s)


# ---- setup flow ---------------------------------------------------------------------
def setup_flow():
    W, H = 900, 250
    steps = [('Install', 'Phone + USB-OTG,', 'app: Install firmware'), ('Pair', 'Tap DotGlow-XXXX,', 'type the PIN shown'),
             ('WiFi', 'Pick your network', 'in the app'), ('Done!', 'Internet time,', 'every setting in the app')]
    s = [f"<svg xmlns='http://www.w3.org/2000/svg' viewBox='0 0 {W} {H}' width='{W}' height='{H}'>",
         f"<rect width='{W}' height='{H}' rx='20' fill='#14161c'/>"]
    cw, gap = 185, 32
    x0 = (W - (4 * cw + 3 * gap)) / 2
    for i, (title, l1, l2) in enumerate(steps):
        x = x0 + i * (cw + gap)
        delay = i * 0.6
        s.append('<g>')
        s.append(f"<rect x='{x}' y='40' width='{cw}' height='170' rx='16' fill='#1c1f28' stroke='#3a3f4b' stroke-width='2'>"
                 f"<animate attributeName='stroke' values='#3a3f4b;#ff3b3b;#ff3b3b;#3a3f4b' keyTimes='0;0.1;0.25;0.35' "
                 f"dur='2.4s' begin='{delay}s' repeatCount='indefinite'/></rect>")
        s.append(f"<circle cx='{x + cw / 2}' cy='82' r='22' fill='#ff3b3b'>"
                 f"<animate attributeName='r' values='22;27;22;22' keyTimes='0;0.1;0.25;1' dur='2.4s' begin='{delay}s' repeatCount='indefinite'/></circle>")
        s.append(f"<text x='{x + cw / 2}' y='90' text-anchor='middle' {FONT} font-size='22' font-weight='700' fill='#fff'>{i + 1}</text>")
        s.append(f"<text x='{x + cw / 2}' y='138' text-anchor='middle' {FONT} font-size='19' font-weight='700' fill='#f2f3f7'>{title}</text>")
        s.append(f"<text x='{x + cw / 2}' y='164' text-anchor='middle' {FONT} font-size='13.5' fill='#9aa0ad'>{l1}</text>")
        s.append(f"<text x='{x + cw / 2}' y='184' text-anchor='middle' {FONT} font-size='13.5' fill='#9aa0ad'>{l2}</text>")
        s.append('</g>')
        if i < 3:
            ax = x + cw + 6
            s.append(f"<path d='M{ax} 125 l{gap - 14} 0 m-7 -7 l7 7 l-7 7' fill='none' stroke='#5a5f6b' stroke-width='3' stroke-linecap='round'/>")
    s.append('</svg>')
    return '\n'.join(s)


# ---- frame-by-frame ports of the firmware animations ---------------------------------
# Each generator yields (frame, seconds) pairs; frame is a set of lit (x, y) pixels.
# frames_svg() turns that into one looping SVG in which every LED that ever lights up
# gets a discrete opacity animation, keyed only at the moments it changes.

W8, H8 = 32, 8


def frames_svg(frames, pitch=12):
    m = Matrix(14, 14, pitch)
    W, H = int(m.w() + 28), int(m.h() + 28)
    total = sum(d for _, d in frames)
    starts, t = [], 0.0
    for _, d in frames:
        starts.append(t / total)
        t += d
    s = [f"<svg xmlns='http://www.w3.org/2000/svg' viewBox='0 0 {W} {H}' width='{W}' height='{H}'>",
         f"<defs>{GLOW}</defs>", m.background(10), "<g filter='url(#glow)'>"]
    for y in range(H8):
        for x in range(W8):
            states = [(x, y) in f for f, _ in frames]
            if not any(states):
                continue
            vals, keys = [], []
            for i, on in enumerate(states):
                if i == 0 or on != states[i - 1]:
                    vals.append('1' if on else '0')
                    keys.append(f'{starts[i]:.4f}')
            if len(vals) == 1:
                s.append(m.dot(x, y))
                continue
            s.append(f"<circle cx='{m.cx(x):g}' cy='{m.cy(y):g}' r='{m.p * 0.36:g}' fill='{RED}' opacity='{vals[0]}'>"
                     f"<animate attributeName='opacity' values='{';'.join(vals)}' keyTimes='{';'.join(keys)}' "
                     f"calcMode='discrete' dur='{total:.2f}s' repeatCount='indefinite'/></circle>")
    s.append('</g></svg>')
    return '\n'.join(s)


def put(frame, x, y):
    if 0 <= x < W8 and 0 <= y < H8:
        frame.add((x, y))


# -- clock face: same layout, digits and transitions as ClockFace in src/display.cpp
FRAMES = 12


def dpx(d, r, c):
    return d is not None and 0 <= r < 7 and 0 <= c < 5 and bool(DIGITS[d][r] & (0x10 >> c))


def draw_digit(f, x, d, ox=0, oy=0):
    for r in range(7):
        for c in range(5):
            if dpx(d, r - oy, c - ox):
                put(f, x + c, r)


def draw_squashed(f, x, d, h):
    if h <= 0:
        return
    top = 3 - h // 2
    for r in range(h):
        for c in range(5):
            if dpx(d, r * 7 // h, c):
                put(f, x + c, top + r)


def draw_slot(f, style, slot, x, a, b, p):
    if style == 'up':
        s = p * 8 // FRAMES
        draw_digit(f, x, a, 0, -s); draw_digit(f, x, b, 0, 8 - s)
    elif style == 'dissolve':
        k = p * 35 // FRAMES
        for r in range(7):
            for c in range(5):
                order = ((r * 5 + c) * 23 + slot * 11) % 35
                if dpx(b, r, c) if order < k else dpx(a, r, c):
                    put(f, x + c, r)
    elif style == 'slide':
        s = p * 6 // FRAMES
        draw_digit(f, x, a, -s, 0); draw_digit(f, x, b, 6 - s, 0)
    elif style == 'flip':
        half = FRAMES // 2
        if p < half:
            draw_squashed(f, x, a, 7 - p * 7 // half)
        else:
            draw_squashed(f, x, b, (p - half + 1) * 7 // half)
    elif style == 'drop':
        bounce = [-8, -6, -4, -2, 0, -2, -3, -2, 0, -1, 0, 0]
        draw_digit(f, x, a, 0, p * p // 2); draw_digit(f, x, b, 0, bounce[p])
    else:   # down
        s = p * 8 // FRAMES
        draw_digit(f, x, a, 0, s); draw_digit(f, x, b, 0, s - 8)


def face(digits_from, digits_to, style, p):
    f = set()
    for c in (0, 1):
        for r in (1, 2, 4, 5):
            put(f, COLON_X + c, r)
    for i in range(4):
        a, b = digits_from[i], digits_to[i]
        if p is None or a == b:
            draw_digit(f, DIGIT_X[i], b)
        else:
            draw_slot(f, style, i, DIGIT_X[i], a, b, p)
    return f


def digit_demo(style):
    t1, t2 = (0, 9, 5, 9), (1, 0, 0, 0)          # 09:59 -> 10:00 -> 09:59 ...
    frames, step = [], 0.06                       # shown at half the clock's speed so it's easy to follow
    for a, b in ((t1, t2), (t2, t1)):
        frames.append((face(a, a, style, None), 1.1))
        frames += [(face(a, b, style, p), step) for p in range(FRAMES)]
    return frames_svg(frames)


# -- effects: same logic as src/display.cpp (random ones use a fixed seed)
def fx_sparkle():
    import random
    rnd, f, out = random.Random(7), set(), []
    for i in range(80):
        on = i < 40
        for _ in range(7):
            p = (rnd.randrange(W8), rnd.randrange(H8))
            (f.add if on else f.discard)(p)
        if i >= 70:
            f = set()
        out.append((set(f), 0.028 * 1.5))
    out.append((set(), 0.6))
    return out


def fx_wipe():
    f, out = set(), []
    for pas in range(2):
        for x in range(W8):
            for y in range(H8):
                (f.add if pas == 0 else f.discard)((x, y))
            out.append((set(f), 0.03))
    out.append((set(), 0.6))
    return out


def fx_rain():
    import random
    rnd, n, out = random.Random(3), 12, []
    dx = [rnd.randrange(W8) for _ in range(n)]
    dy = [-rnd.randrange(14) for _ in range(n)]
    for i in range(110):
        f = set()
        for k in range(n):
            put(f, dx[k], dy[k]); put(f, dx[k], dy[k] - 1)
            if i & 1:
                put(f, dx[k], dy[k] - 2)
            dy[k] += 1
            if dy[k] > H8 + 2 and i < 85:
                dx[k], dy[k] = rnd.randrange(W8), -rnd.randrange(6)
        out.append((f, 0.05))
    out.append((set(), 0.4))
    return out


def fx_boxes():
    out, cx = [], W8 // 2 - 1
    for _ in range(3):
        for r in range(W8 // 2 + 2):
            f = set()
            x0, x1, y0, y1 = cx - r, cx + 1 + r, 3 - r, 4 + r
            for x in range(x0, x1 + 1):
                put(f, x, y0); put(f, x, y1)
            for y in range(y0, y1 + 1):
                put(f, x0, y); put(f, x1, y)
            out.append((f, 0.045))
    out.append((set(), 0.5))
    return out


def system():
    """Phone <-> clock over Bluetooth, clock <-> internet over WiFi, with moving packets."""
    W, H = 900, 300
    s = [f"<svg xmlns='http://www.w3.org/2000/svg' viewBox='0 0 {W} {H}' width='{W}' height='{H}'>",
         f"<rect width='{W}' height='{H}' rx='20' fill='#14161c'/>"]

    def box(x, y, w, h, title, lines, fill='#1c1f28', stroke='#3a3f4b'):
        s.append(f"<rect x='{x}' y='{y}' width='{w}' height='{h}' rx='16' fill='{fill}' stroke='{stroke}' stroke-width='2'/>")
        s.append(f"<text x='{x + w / 2}' y='{y + 36}' text-anchor='middle' {FONT} font-size='19' font-weight='700' fill='#f2f3f7'>{title}</text>")
        for k, l in enumerate(lines):
            s.append(f"<text x='{x + w / 2}' y='{y + 62 + k * 20}' text-anchor='middle' {FONT} font-size='13' fill='#9aa0ad'>{l}</text>")

    box(40, 80, 220, 150, 'DotGlow app', ['Android phone', 'settings · WiFi setup', 'updates · USB flasher'])
    box(340, 80, 220, 150, 'DotGlow clock', ['ESP32 / ESP32-S3', 'MAX7219 display', 'web page · API'], '#10353a', '#1f6b72')
    box(640, 80, 220, 150, 'Internet', ['NTP time', 'firmware releases', 'manoranjan.dev / GitHub'])

    def link(x1, x2, y, label, col, dur):
        s.append(f"<path d='M{x1} {y} L{x2} {y}' stroke='{col}' stroke-width='3' stroke-dasharray='6 6' opacity='0.6'/>")
        s.append(f"<text x='{(x1 + x2) / 2}' y='{y - 12}' text-anchor='middle' {FONT} font-size='12' fill='{col}'>{label}</text>")
        for k, (a, b) in enumerate(((x1, x2), (x2, x1))):
            s.append(f"<circle r='5' cy='{y + (k * 2 - 1) * 0}' fill='{col}'><animate attributeName='cx' values='{a};{b}' "
                     f"dur='{dur}s' begin='{k * dur / 2}s' repeatCount='indefinite'/></circle>")

    link(262, 338, 140, 'Bluetooth LE', '#4da3ff', 1.6)
    link(562, 638, 140, 'WiFi', '#35d07f', 1.9)
    s.append(f"<text x='{W / 2}' y='270' text-anchor='middle' {FONT} font-size='13' fill='#9aa0ad'>"
             "Paired + encrypted Bluetooth (PIN on the display) · the clock works without the phone</text>")
    s.append('</svg>')
    return '\n'.join(s)


def stopwatch_frames():
    """00:00 counting up, tenths filling the bottom row (firmware drawStopwatch)."""
    out = []
    for t in range(0, 64):            # 6.4 s in tenths
        f = set()
        sec = t // 10
        for i, d in enumerate((0, 0, 0, sec)):
            draw_digit(f, DIGIT_X[i], d)
        for c in (0, 1):
            for r in (1, 2, 4, 5):
                put(f, COLON_X + c, r)
        for x in range((t % 10) * W8 // 10):
            put(f, x, 7)
        out.append((f, 0.1))
    return out


def sw_face(d4, bar):
    """Stopwatch face on 4 modules: 4 digits, colon, bottom-row bar of `bar` pixels (firmware drawStopwatch)."""
    f = set()
    for i, d in enumerate(d4):
        draw_digit(f, DIGIT_X[i], d)
    for c in (0, 1):
        for r in (1, 2, 4, 5):
            put(f, COLON_X + c, r)
    for x in range(bar):
        put(f, x, 7)
    return f


def stopwatch_paused():
    """Paused at 01:23.4: digits blink (650 ms on, 350 ms off), the tenths bar stays."""
    out = []
    for _ in range(3):
        out.append((sw_face((0, 1, 2, 3), 4 * W8 // 10), 0.65))
        f = set(); [put(f, x, 7) for x in range(4 * W8 // 10)]
        out.append((f, 0.35))
    return out


def stopwatch_hours():
    """After an hour: HH:MM, and the bottom row fills once per minute (sped up here)."""
    out = []
    for m in (5, 6):
        for k in range(16):
            out.append((sw_face((0, 1, 0, m), (k + 1) * W8 // 16), 0.12))
    return out


def power():
    """A 5 V charger powers the clock; the display hangs off 5V/VIN with a capacitor."""
    W, H = 900, 330
    s = [f"<svg xmlns='http://www.w3.org/2000/svg' viewBox='0 0 {W} {H}' width='{W}' height='{H}'>",
         f"<rect width='{W}' height='{H}' rx='20' fill='#14161c'/>",
         # charger
         "<rect x='40' y='80' width='150' height='120' rx='16' fill='#262a33' stroke='#7c8190' stroke-width='2'/>",
         "<rect x='68' y='58' width='22' height='24' rx='3' fill='#aeb2bc'/><rect x='140' y='58' width='22' height='24' rx='3' fill='#aeb2bc'/>",
         f"<text x='115' y='136' text-anchor='middle' {FONT} font-size='28' font-weight='800' fill='#f2f3f7'>5 V</text>",
         f"<text x='115' y='164' text-anchor='middle' {FONT} font-size='13' fill='#9aa0ad'>1 A or more</text>",
         f"<text x='115' y='226' text-anchor='middle' {FONT} font-size='13' fill='#9aa0ad'>phone charger</text>",
         "<path d='M190 140 L280 140' stroke='#c8ccd6' stroke-width='6'/>",
         f"<text x='235' y='128' text-anchor='middle' {FONT} font-size='12' fill='#9aa0ad'>USB</text>",
         # board
         "<rect x='280' y='70' width='200' height='150' rx='14' fill='#10353a' stroke='#1f6b72' stroke-width='2'/>",
         f"<text x='380' y='104' text-anchor='middle' {FONT} font-size='16' font-weight='700' fill='#f2f3f7'>ESP32 / ESP32-S3</text>",
         f"<text x='468' y='154' text-anchor='end' {FONT} font-size='13' fill='#e8eaf0'>5V / VIN</text>",
         f"<text x='468' y='194' text-anchor='end' {FONT} font-size='13' fill='#e8eaf0'>GND</text>",
         # wires + capacitor
         "<path d='M480 150 L560 150 L560 120 L640 120' fill='none' stroke='#ff4d4d' stroke-width='4'/>",
         "<path d='M480 190 L540 190 L540 170 L640 170' fill='none' stroke='#9aa0ad' stroke-width='4'/>",
         "<path d='M580 120 L580 136' stroke='#ff4d4d' stroke-width='3'/><rect x='566' y='136' width='28' height='4' fill='#e8eaf0'/>",
         "<path d='M566 152 Q 580 144 594 152' fill='none' stroke='#e8eaf0' stroke-width='4'/><path d='M580 150 L580 170' stroke='#9aa0ad' stroke-width='3'/>",
         f"<text x='580' y='238' text-anchor='middle' {FONT} font-size='12' fill='#ffc53d'>470-1000 µF (+ to VCC)</text>",
         # display
         "<rect x='640' y='80' width='230' height='130' rx='12' fill='#12324f' stroke='#2a5d8a' stroke-width='2'/>",
         f"<text x='655' y='124' {FONT} font-size='13' fill='#e8eaf0'>VCC</text><text x='655' y='174' {FONT} font-size='13' fill='#e8eaf0'>GND</text>",
         f"<text x='770' y='150' text-anchor='middle' {FONT} font-size='15' font-weight='700' fill='#e8eaf0'>MAX7219</text>",
         f"<text x='770' y='170' text-anchor='middle' {FONT} font-size='12' fill='#9aa0ad'>(IN side)</text>",
         f"<text x='{W / 2}' y='278' text-anchor='middle' {FONT} font-size='14' fill='#ff8a8a'>"
         "A computer USB port is too weak: dim or garbled display, all LEDs stuck on, the board restarts</text>",
         f"<text x='{W / 2}' y='302' text-anchor='middle' {FONT} font-size='13' fill='#9aa0ad'>"
         "8+ modules: separate 5 V / 2-4 A supply for the display, GND joined to the ESP32 GND</text>",
         '</svg>']
    return '\n'.join(s)


def button():
    W, H = 900, 260
    s = [f"<svg xmlns='http://www.w3.org/2000/svg' viewBox='0 0 {W} {H}' width='{W}' height='{H}'>",
         f"<rect width='{W}' height='{H}' rx='20' fill='#14161c'/>",
         "<rect x='50' y='50' width='240' height='160' rx='14' fill='#10353a' stroke='#1f6b72' stroke-width='2'/>",
         f"<text x='170' y='95' text-anchor='middle' {FONT} font-size='18' font-weight='700' fill='#f2f3f7'>ESP32 / S3</text>",
         f"<text x='270' y='145' text-anchor='end' {FONT} font-size='14' fill='#e8eaf0'>GPIO4 (S3) · GPIO13</text>",
         f"<text x='270' y='185' text-anchor='end' {FONT} font-size='14' fill='#e8eaf0'>GND</text>",
         "<path d='M290 140 L560 140' stroke='#ffc53d' stroke-width='4'/><path d='M290 180 L560 180' stroke='#9aa0ad' stroke-width='4'/>",
         "<rect x='560' y='110' width='120' height='100' rx='14' fill='#262a33' stroke='#5a5f6b' stroke-width='2'/>",
         "<circle cx='620' cy='160' r='30' fill='#ff3b3b'><animate attributeName='r' values='30;26;30;30' keyTimes='0;0.08;0.16;1' dur='2s' repeatCount='indefinite'/></circle>",
         f"<text x='620' y='240' text-anchor='middle' {FONT} font-size='13' fill='#9aa0ad'>push button</text>",
         f"<text x='710' y='140' {FONT} font-size='14' fill='#e8eaf0'>tap: start / pause</text>",
         f"<text x='710' y='164' {FONT} font-size='14' fill='#e8eaf0'>hold: reset</text>",
         f"<text x='710' y='188' {FONT} font-size='14' fill='#e8eaf0'>hold at 0: clock</text>",
         '</svg>']
    return '\n'.join(s)


IMAGES = [('banner', banner), ('pacman', pacman), ('wiring-esp32s3', lambda: wiring('esp32s3')),
          ('wiring-esp32', lambda: wiring('esp32')), ('setup', setup_flow), ('chain', chain), ('system', system),
          ('stopwatch', lambda: frames_svg(stopwatch_frames())), ('stopwatch-paused', lambda: frames_svg(stopwatch_paused())),
          ('stopwatch-hours', lambda: frames_svg(stopwatch_hours())), ('button', button), ('power', power)]
IMAGES += [(f'digits-{s}', (lambda s=s: digit_demo(s))) for s in ('down', 'up', 'dissolve', 'slide', 'flip', 'drop')]
IMAGES += [('fx-sparkle', lambda: frames_svg(fx_sparkle())), ('fx-wipe', lambda: frames_svg(fx_wipe())),
           ('fx-rain', lambda: frames_svg(fx_rain())), ('fx-boxes', lambda: frames_svg(fx_boxes()))]

for name, fn in IMAGES:
    path = os.path.join(OUT, name + '.svg')
    with open(path, 'w', encoding='utf-8', newline='\n') as f:
        f.write(fn() + '\n')
    print(f'{name}.svg: {os.path.getsize(path) // 1024} KB')
