ElectroIoT/DotGlow-ESP32/(commit log)

2026-10-02 DotGlow ESP32 firmware, phase 1: port of the ESP8266 Matrix Clock
    Builds for esp32dev and esp32-s3-devkitc-1 (min_spiffs: 2x ~1.9 MB app slots).
    - WebServer / Update / mbedTLS SHA-256 / esp_fill_random instead of the
    ESP8266 equivalents; settings in NVS (Preferences) instead of EEPROM
    - safe mode uses esp_reset_reason() + RTC_NOINIT memory
    - GitHub updates: one verified TLS client with all 7 roots, per-chip
    firmware assets (firmware-esp32.bin / firmware-esp32s3.bin)
    - DotGlow naming: hotspot DotGlow-XXXX, dotglow.local
    - WiFi stack started before the web server (ESP32 asserts otherwise)
    Tested on ESP32-S3 N16R8: boots, opens the setup hotspot, no restarts.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
2026-10-02 Phase 2: Bluetooth service and shared command layer
    - api.cpp: every web API operation moved out of web.cpp into apiCall(op,
    args, trusted), used by both HTTP and Bluetooth; web.cpp keeps only
    pages, login cookie, captive portal and .bin upload
    - ble.cpp (NimBLE): DotGlow service with INFO (open), RX/TX (encrypted +
    authenticated); LE Secure Connections, display-only pairing with a
    6-digit PIN shown on the LED display; line-delimited JSON requests,
    chunked to the MTU, handled in the main loop
    - docs/PROTOCOL.md: GATT layout, pairing, message format, operations
2026-10-02 Test build that prints the pairing PIN on serial; phase 2-3 tested on a phone
    env:esp32s3_test adds -DPIN_TO_SERIAL so a developer can pair while no
    display is connected. Release builds keep the PIN on the LED display only.
    Tested: Motorola Edge 40 Neo (Android 15) found, paired (LE Secure
    Connections, PIN) and read status/config over the encrypted link.
2026-10-02 Phase 5-6: firmware updates over Bluetooth, release images for USB flashing
    - OTA characteristic + ota/begin, ota/end, ota/status, ota/abort; progress
    bar on the display while an image arrives
    - INFO reports the release asset and Bluetooth update support
    - tools/release.py: app images, full images (bootloader + partitions + app)
    for flashing at 0x0, and firmware.json for the app
    - ESP32-S3 builds use a 4 MB flash header so they run on every S3 module
    - Version 0.2.0
2026-10-02 Faster Bluetooth updates, drop links that never pair
    - OTA characteristic also takes writes without response, and the clock asks
    for a 7.5-15 ms connection interval during an update: 98 s -> 26 s for
    1.2 MB (tested on a Motorola Edge 40 Neo)
    - A connection that is not encrypted after 60 s is dropped: a phone could
    leave one behind and then fail to reconnect
    - Connect log shows the connection interval; update log shows the speed
    [ble.cpp]
2026-10-02 Stopwatch with an optional button (0.3.0)
    - New 'stopwatch' op (start, pause, toggle, reset, open, exit); status
    carries {on, run, ms}
    - Display: MM:SS (HH:MM after an hour, HH:MM:SS on 6+ modules), tenths on
    the bottom row, blinking while paused
    - Optional push button: GPIO4 (S3) / GPIO13 (ESP32) to GND. Tap = start /
    pause, hold = reset, hold at 0 = back to the clock
    - Version 0.3.0
    [api.cpp, config.h, display.cpp, display.h, main.cpp, stopwatch.cpp, stopwatch.h]
2026-10-02 New README with animated SVGs, developer docs
    - README: features, every digit style and effect as animated SVG, system
    diagram, parts, wiring for both boards, power table, 3 ways to install,
    first setup, stopwatch, updates, troubleshooting
    - tools/make_images.py: DotGlow banner, wiring per board, setup flow,
    system diagram, stopwatch and button pictures
    - docs: ARCHITECTURE, DEVELOPMENT, RELEASE; CHANGELOG; CLAUDE.md and
    AGENTS.md as a brief for AI assistants
2026-10-02 Stopwatch pictures in the README, esp32dev_test env
    - README Stopwatch section: running, paused (blinking) and after-an-hour
    pictures of the display
    - esp32dev_test: classic ESP32 build that prints the pairing PIN on
    serial; tested on an ESP32-D0WD-V3 (CH340): USB install from the app's
    flasher (32 s, MD5 ok), pairing, WiFi scan, stopwatch
2026-10-03 Display test firmware (tools/display-test)
    Standalone MAX7219 check without the clock firmware: pin shorts, the
    chip's all-LEDs-on test register, module numbers, rows, columns and a
    brightness ramp, with a serial report and brownout detection. Found a
    broken module chain (module 1 works, 2-4 stay lit) on a test display.
    [main.cpp]
2026-10-03 Rotate 180 with a BOOT double press; power guide (0.3.1)
    - BOOT button: double press turns the display upside down and back
    - README: power section and picture (5 V / 1 A charger required; a PC USB
    port caused the dim / stuck / garbled displays and restarts in testing),
    ESP32 DevKit flash-pin warning, new troubleshooting rows, rotate
    - Version 0.3.1
    [config.h, main.cpp, make_images.py]
2026-10-05 3D-printed case: leaning desk case with smoked front, DC jack back plate
    Parametric OpenSCAD (hardware/enclosure): lean angle, screw or snap back,
    PCB or panel DC jack, optional USB-C slot, 12x12 button rails, LDR.
    STLs (shell, back, test fit + variants) and preview renders.
    [dotglow-back-panel-jack.stl, dotglow-back-snap.stl, dotglow-back.stl, dotglow-shell-lean30.stl, dotglow-shell-snap.stl, dotglow-shell.stl, dotglow-testfit.stl, dotglow_case.scad]
2026-10-05 Case: DC-005 glue-in cradle and ESP32 snap cradle
    DC-005 sits front-face on the plate with glue windows and free pins for
    soldering; ESP32 gets side guides and a snap hook (board_mount option,
    tape-only variant kept).
    [dotglow-back-panel-jack.stl, dotglow-back-snap.stl, dotglow-back-tape.stl, dotglow-back.stl, dotglow_case.scad]
2026-10-05 Case: presets for 6 boards, button / no-button and snap variants
    ESP32-S3, ESP32 DevKit 30 / 38 pin, ESP8266 NodeMCU v2 / v3, D1 mini.
    Display now clicks in behind four flexing hooks; back plate posts skip
    wide boards. tools_export.sh rebuilds every STL. README: board picker,
    per-board wiring (ESP8266 button = FLASH).
    [back-snap.stl, back.stl, dotglow-back-panel-jack.stl, dotglow-back-snap.stl, dotglow-back-tape.stl, dotglow-back.stl, dotglow-shell.stl, dotglow-testfit.stl]
2026-10-05 Case: 6-module (8x48) STLs for every board, turned 45 deg for 220 mm beds
    bed_rotate option; STLs converted to binary (23 MB -> 7 MB for the
    4-module set); tools_export.sh takes the module count. Preview centres the
    time on wider displays.
    [back-snap.stl, back.stl, dotglow-testfit.stl, dotglow_case.scad, esp32-s3-back-panel-jack.stl, esp32-s3-back-tape.stl, esp32-s3-shell-lean30-button.stl, shell-button.stl]
2026-10-05 Case: 6-module plus set (light shield, name plate, DHT22 pocket)
    Light shield grid with a seat in the shell, ElectroIoT.in engraved in the
    base (+ inlay letters), DHT22 pocket behind a heat partition with vents.
    New options shield / nameplate / plate_text / dht22, off by default; the
    existing sets are unchanged. DHT22 is mounting only, firmware planned.
    [back-snap.stl, back.stl, dotglow-light-shield.stl, dotglow-nameplate-inlay.stl, dotglow-testfit.stl, dotglow_case.scad, shell-button.stl, shell-no-button.stl]
2026-10-06 README: ground and flashing troubleshooting rows
2026-10-06 Desktop flasher: window and command line to install firmware from a PC
    Detects ESP32 / ESP32-S3 / ESP8266, downloads the latest firmware from the
    catalog (MD5-checked, cached), full install or app-only update that keeps
    settings. PyInstaller build script; sources only (exe files are not committed).
2026-10-06 Desktop flasher: CI build + SignPath signing setup, licence notice
    esptool is GPL-2.0-or-later and ships inside the exe, so the flasher is
    GPL-2.0-or-later; documented in NOTICE.md. Workflow builds on GitHub
    runners; signing is switched on by a repo variable once SignPath approves.
2026-10-18 DotGlow V1 board: ESP32-S3-MINI-1 + USB-C + MAX98357A speaker + 74AHCT125 level shifter, 128x33 mm, KiCad project, fab files, README
    [dotglow-v1-B_Cu.gbl, dotglow-v1-B_Mask.gbs, dotglow-v1-B_Paste.gbp, dotglow-v1-B_Silkscreen.gbo, dotglow-v1-Edge_Cuts.gm1, dotglow-v1-F_Cu.gtl, dotglow-v1-F_Mask.gts, dotglow-v1-F_Paste.gtp]
2026-10-18 DotGlow V1 board: stopwatch header J7, routing rerun, layout-only package for EasyEDA (outline, DXF, placement CSV)
    [dotglow-v1-Edge_Cuts.dxf, dotglow-v1-F_Courtyard.dxf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]
2026-10-18 Layout package: single-file DXFs (outline + holes, full layout)
    [dotglow-v1-Edge_Cuts.dxf, dotglow-v1-F_Courtyard.dxf, dotglow-v1-F_Silkscreen.dxf, dotglow-v1-User_Drawings.dxf, dotglow-v1-full-layout.dxf, dotglow-v1-outline-holes.dxf]
2026-10-19 DotGlow V1 board: switch to ESP32-S3-WROOM-1-N16R8 (C2913202), full pinout doc, display header on the module end, rebuild script
    [dotglow-v1-B_Cu.gbl, dotglow-v1-B_Mask.gbs, dotglow-v1-B_Paste.gbp, dotglow-v1-B_Silkscreen.gbo, dotglow-v1-Edge_Cuts.gm1, dotglow-v1-F_Cu.gtl, dotglow-v1-F_Mask.gts, dotglow-v1-F_Paste.gtp]
2026-10-19 DotGlow V1 board: JST XA connectors (2-pin C265077, 3-pin C265055, 4-pin C491709) for speaker, stopwatch, LDR, DHT22, I2C; re-placed and re-routed
    [dotglow-v1-B_Cu.gbl, dotglow-v1-B_Mask.gbs, dotglow-v1-B_Paste.gbp, dotglow-v1-B_Silkscreen.gbo, dotglow-v1-Edge_Cuts.gm1, dotglow-v1-F_Cu.gtl, dotglow-v1-F_Mask.gts, dotglow-v1-F_Paste.gtp]
2026-10-19 DotGlow V1 board: LCSC C492404 for the 5-pin display header
    [dotglow-v1-B_Cu.gbl, dotglow-v1-B_Mask.gbs, dotglow-v1-B_Paste.gbp, dotglow-v1-B_Silkscreen.gbo, dotglow-v1-Edge_Cuts.gm1, dotglow-v1-F_Cu.gtl, dotglow-v1-F_Mask.gts, dotglow-v1-F_Paste.gtp]
2026-10-19 DotGlow V1 board: LCSC C155176 for the 74AHCT125
    [dotglow-v1-B_Cu.gbl, dotglow-v1-B_Mask.gbs, dotglow-v1-B_Paste.gbp, dotglow-v1-B_Silkscreen.gbo, dotglow-v1-Edge_Cuts.gm1, dotglow-v1-F_Cu.gtl, dotglow-v1-F_Mask.gts, dotglow-v1-F_Paste.gtp]
2026-10-20 DotGlow V1 board: final EasyEDA files (schematic, PCB, BOM, Gerber), 3D renders and viewer angles, README banner, HyperFrames short video source
    [dotglow-v1-B_Cu.gbl, dotglow-v1-B_Mask.gbs, dotglow-v1-B_Paste.gbp, dotglow-v1-B_Silkscreen.gbo, dotglow-v1-Edge_Cuts.gm1, dotglow-v1-F_Cu.gtl, dotglow-v1-F_Mask.gts, dotglow-v1-F_Paste.gtp]
2026-10-20 PCB video thumbnails (vertical 1080x1920 and wide 1280x720)
2026-10-20 README: link the PCB YouTube Short
2026-10-20 Silkscreen logos: PCBWay and ElectroIoT.in (transparent PNG, black and white)
2026-10-20 PCB images with logos: 2D layout, 3D top/bottom/angle, PCBWay cover
2026-10-20 Gerber export with the PCBWay and ElectroIoT.in silkscreen logos
2026-10-20 Silkscreen logos: OSHWLab and EasyEDA (SVG + transparent PNG)
2026-10-20 Final PCB images with 4 logos (2D layout and 3D top/bottom/angle)
2026-10-20 Add OSHWLab/PCBWay cover images
2026-10-20 README: mark ESP32/ESP32-S3 port as working
2026-10-22 Add BOM folder and README maps (repo, hardware, docs)
    [dotglow-v1-bom.csv, dotglow-v1-bom.xlsx]
2026-10-22 Schematic PDF: replace title-block logo with ElectroIoT.in / manoranjan.dev
